riscv-mcu/e203_hbirdv2/doc/source/index.rst

.. Nuclei Board Labs documentation master file.
   You can adapt this file completely to your liking, but it should at least
   contain the root `toctree` directive.

.. toctree::
   :maxdepth: 5
   :caption: Hummingbirdv2 E203 Core and SoC
   :numbered:

Hummingbirdv2 E203 Core and SoC
===============================

.. toctree::
   :maxdepth: 3
   :numbered:

   overview/overview.rst
   core/core.rst
   soc_peripherals/ips.rst
   quick_start/index.rst
   changelog.rst
   license.rst
   appendix.rst
   glossary.rst

Indices and tables
==================

* :ref:`genindex`
* :ref:`search`
