riscv-mcu/e203_hbirdv2/doc/source/asserts/medias/sdk_fig9.jpg

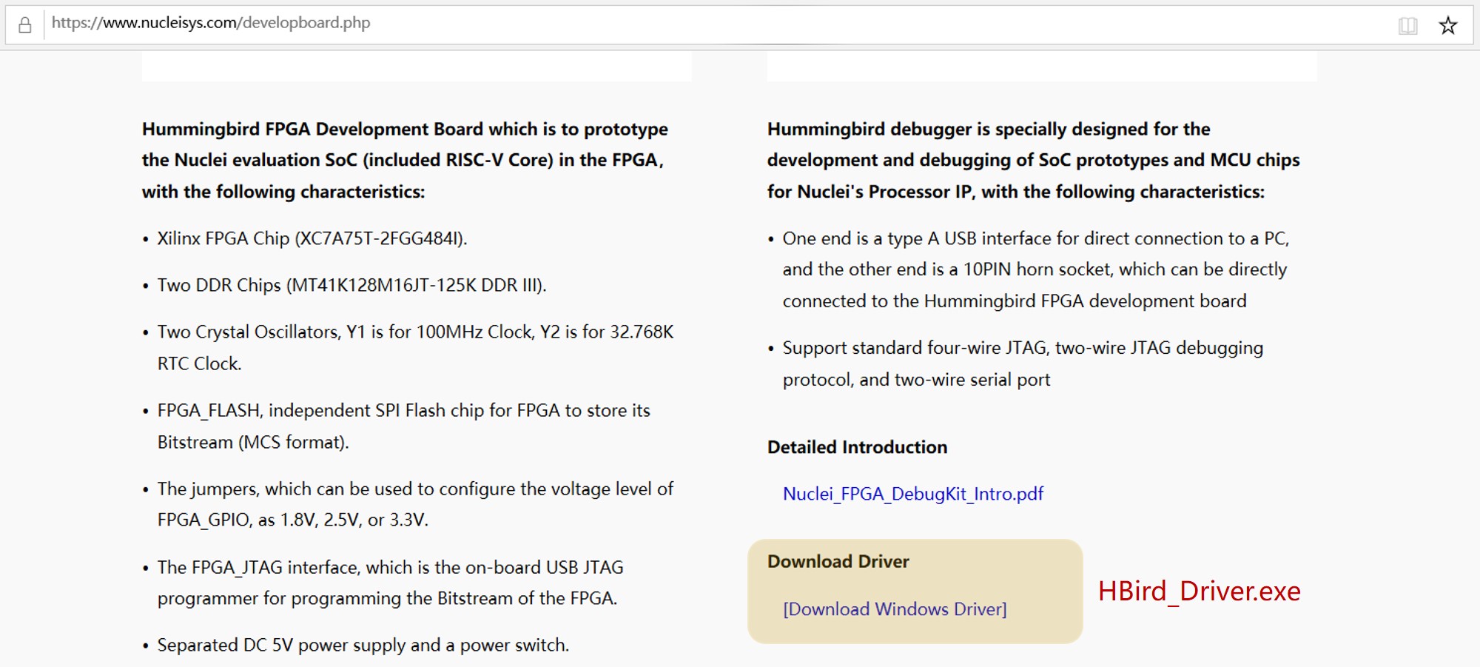
doc/source/asserts/medias/sdk_fig9.jpg
