riscv-mcu/e203_hbirdv2/(threads)

Thread 1 (2020-07-31):

Docs for NICE interface

mfkiwl, 2020-07-31:
Thank you very much for sharing the revised version of E203. It is nice to have the NICE co-processor interface included in your code.

The problem now is how to write users' own co-processors/accelerators. Any Docs on the NICE interface? It will be best if examples can be included.

Regards,
Xing

hucan7, 2020-08-03:
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

We will provide a simple user case for NICE co-processing, and the related document is ongoing... When it's ready, I will update that in README.

Thanks,
Hu Can

fanghuaqi, 2020-10-30:
See https://doc.nucleisys.com/hbirdv2

Closed 2020-08-03.

Thread 2 (2021-03-09):

question occurs when i run qsort example program on e203

zhvn100, 2021-03-09:
subprogram  can‘t  return main function through ret instr. For example, verify_qsort funct can't return main, when executing 0x80001074  pc  directly jumps to 0x00000000  ,then jumps to  interrupt funct - trap_entry(0x80000120) ，as shown in the figure below。
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。
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

According to my understanding，the  right  process  is  that verify_qsot returns to main , main returns to _init , _init returns to exit.
So , please tell me whether qsort  program can run on e203 , or where does problem maybe occur ?

hucan7, 2021-03-29:
Actually，I tried to run a test which contains qsort func on hbirdv2 SoC, and finally the result was successful.
For your case，I suggest you may check whether the "ret" is  executed correctly through checking more related signals at first.

zhvn100, 2021-03-31:
qsort func is under the benchmark dir.  whether  you  use  objcopy  to get verilog(bin) file from original  riscv(elf) file. Then through tb.v  , dump  instuction into imem.

Thread 9 (2022-08-12):

关于PLIC部分代码是否可综合问题（Is the plic code synthesizable ？ ）

clancylea, 2022-08-12:
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

please  ，Is the plic code synthesizable ？，Thanks！

hucan7, 2022-08-31:
> 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
>
> please ，Is the plic code synthesizable ？，Thanks！

Of course，you can have a try，or what's the problem you have when you did the synthesize

clancylea, 2024-11-28:
thank you，sir

Closed 2024-11-28.

Thread 10 (2022-08-31):

Nuclei Studio IDE User guide for e203_hbirdv2 is not update to date 蜂鸟二代IDE使用文档对不上

fanghuaqi, 2022-08-31:
根据文档所描述的 https://doc.nucleisys.com/hbirdv2/quick_start/ide.html 下载IDE，发现没法和最新的IDE匹配上请更新。

这里的文档能匹配的应该是 2020.09版本

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

最新的 2022.04版本无法正常使用，最新的版本使用的是NPK方式，请参照IDE文档。

蜂鸟v1/v2这里采用的hbird-sdk的NPK包，可以从https://github.com/riscv-mcu/hbird-sdk/releases/tag/0.1.3 这里下载zip包，然后通过Nuclei Package Management导入，然后使用Create Nuclei RISC-V C/C++ Project选择HummingBird对应的开发板和SoC创建对应的使用用例。

fanghuaqi, 2022-08-31:
About Nuclei NPK package, please check https://github.com/Nuclei-Software/nuclei-sdk/wiki/Nuclei-Available-NPK-Zips

fanghuaqi, 2022-08-31:
1. 下载 hbird-sdk的npk包

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

2. 如果使用蜂鸟2代，选择v2的SoC

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

3. 创建helloworld示例

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

hucan7, 2022-10-27:
Doc has been updated.
https://doc.nucleisys.com/hbirdv2/quick_start/ide_latest.html#

Closed 2022-10-27.

Thread 14 (2022-10-27):

Nuclei Studio 2022.08版本无法正常下载程序到hbird/hbirdv2 flash上

fanghuaqi, 2022-10-27:
蜂鸟SoC使用OpenOCD 0.11.0+dev-02420-g[1d0387cb](https://github.com/software/devtools/openocd/-/commit/1d0387cb14dddbf1a8021ff8b792b42f165bbdd9)版本，在ilm下载模式运行正确，在flash/flashxip下载模式会报错，可以连接上，下载时报错，截图如下。

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

fanghuaqi, 2022-10-27:
# **workaround:**

1. [芯来官网](https://www.nucleisys.com/download.php#tools)下载使用2022.04 版本的openocd, 替换掉IDE中toolchain/openocd, 注意替换前后的目录一致性

Thread 17 (2022-12-29):

关于移植到xc7z100ffg9-2出现的问题

Fahrenhell, 2022-12-29:
您好，我想请教一下，我现在把e203移植到另外一块开发板出现了以下的问题：
1、由于这块开发板的特殊性，上面的32.768KHz时钟不能供给PL端使用，所以vivado在综合的时候，这条时序路径会报错。这个问题该怎么解决？是可以忽略的吗？
2、移植过去之后，我把jtag接口和gpioA上的uart接口引了出来但是出现了以下报错：

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
为什么会没有检测到内核？

Fahrenhell, 2022-12-29:
我突然有个想法，不会是蜂鸟jtag调试器不支持xc7z100ffg9-2吧？

fanghuaqi, 2022-12-29:
可以去社区问问其他人 https://www.rvmcu.com/community-show-id-2.html

> 我突然有个想法，不会是蜂鸟jtag调试器不支持xc7z100ffg9-2吧？

蜂鸟调试器不存在不支持特定fpga的说法，一般都是自己移植没到位。

Fahrenhell, 2022-12-29:
那我再问一下，蜂鸟jtag调试器上面的uart tx和rx是连到gpioA的17和16吗？gpioA的其他引脚会影响jtag吗？因为我不想用那么多gpioA上的引脚，所以就只引了uart出来。

fanghuaqi, 2022-12-29:
> 那我再问一下，蜂鸟jtag调试器上面的uart tx和rx是连到gpioA的17和16吗？gpioA的其他引脚会影响jtag吗？因为我不想用那么多gpioA上的引脚，所以就只引了uart出来。

这个我不了解，建议仔细阅读代码和相关文档。

Fahrenhell, 2022-12-29:
那除了使用jtag，还有什么其他的办法可以知道e203跑起来了呢？

fanghuaqi, 2022-12-29:
https://doc.nucleisys.com/hbirdv2/quick_start/index.html

Fahrenhell, 2022-12-29:
这不是还是要用jtag？

Closed 2022-12-29.

Thread 19 (2023-03-10):

跑仿真遇到的一些问题

cyl-0411, 2023-03-10:
### 我根据quickstart里面的指导进行仿真，遇到了以下的一些问题：

#### 1.README存在一些小问题
`/e203_hbirdv2/vsim/README.md`中的第十四行:
原代码：`make compile SIM=iverlog **or** make compile SIM=VCS`
这里的的`iverilog`少了个`i`。

#### 2.对于Ubuntu22.04需要进行额外配置
我进行到`4.1.3. Run simulation tests`时，执行`make run_test SIM=iverilog`命令时报错，报错信息：`Syntax error: "&"unexpected`。
我根据[这个](https://www.jianshu.com/p/89b40e01d983)解决了问题。希望可以将这个问题加入文档中，让以后走到这一步的同学少走一些弯路。

fanghuaqi, 2023-03-10:
可以发个PR修复下 @cyl-0411

fanghuaqi, 2023-04-02:
Fixed by https://github.com/riscv-mcu/e203_hbirdv2/pull/21

Closed 2023-04-02.

Thread 23 (2024-01-27):

regression case rv32um-p-div fail

hbhbts, 2024-01-27:
xrun -r sp_default +DUMPWAVE=1 +TESTCASE=/home/icer/work/test/e203_hbirdv2-master/vsim/run/../../riscv-tools/riscv-tests/isa/generated/rv32um-p-div +SIM_TOOL=xrun 2>&1 | tee rv32um-p-div/rv32um-p-div.log; cd /home/icer/work/test/e203_hbirdv2-master/vsim/run;
TOOL:   xrun    20.09-s009: Started on Jan 27, 2024 at 21:16:47 CST
TOOL:   xrun(64)        20.09-s009: Started on Jan 27, 2024 at 21:16:47 CST
xrun(64): 20.09-s009: (c) Copyright 1995-2021 Cadence Design Systems, Inc.
xrun: *N,NOSNPR: The default work directory (./xcelium.d/run.lnx8664.20.09.d) is missing.  -r sp_default was used and a matching -snapshot sp_default scratch directory was found.  xrun will imply the option -snapshot sp_default.
Loading snapshot worklib.sp_default:v .................... Done
SVSEED default: 1
xmsim: *W,RNDXCELON: A newer version of the SystemVerilog constraint solver is being used which has better support for array-solving, new solve-order mechanism, and seed stability enhancements..
xcelium> source /opt/rh/XCELIUM2009/tools/xcelium/files/xmsimrc
xcelium> run
!!!!!!!!!!!!!!!!!!!!!!!!!!!!!!!!!!!!!!!!!!!!!!!!
TESTCASE=                                                                                                                                                                                                  /home/icer/work/test/e203_hbirdv2-master/vsim/run/../../riscv-tools/riscv-tests/isa/generated/rv32um-p-div
xrun used
xmsim: *W,PRUASZ: Unpacked array at "tb_top.itcm_mem" of 65536 elements exceeds limit of 16384 - not probed
 Use 'probe -create -unpacked 65536 tb_top.itcm_mem' or 'setenv SHM_UNPACKED_LIMIT 65536' to adjust limit.
ITCM 0x00: 340510730001aa0d
ITCM 0x01: ff85051300002517
ITCM 0x02: 01f5222301e52023
ITCM 0x03: 040f416334202f73
ITCM 0x04: 4fa507ff02634fa1
ITCM 0x05: 0c634fad05ff0f63
ITCM 0x06: 0bff05634f8505ff
ITCM 0x07: 4f9d0dff00634f95
ITCM 0x16: 2f03f52505130000
ITCM 0x20: 2f8300052f03f065
??????????????????????????????????????????
??????????????????????????????????????????
{i_mul,i_mulh,i_mulhsu,i_mulhu,i_div,i_divu,i_rem,i_remu}=00001000
muldiv_i_rs1=ffffffec
muldiv_i_rs2=00000006

golden_res=55555552
muldiv_o_wbck_wdat=fffffffd
??????????????????????????????????????????
xmsim: *F,ASRTST (../install/rtl/core/e203_exu_alu_muldiv.v,624): (time 93648 NS) Assertion tb_top.u_e203_soc_top.u_e203_subsys_top.u_e203_subsys_main.u_e203_cpu_top.u_e203_cpu.u_e203_core.u_e203_exu.u_e203_exu_alu.u_e203_exu_alu_muldiv.CHECK_GOLD_AND_ACTUAL_SAME has failed
Memory Usage - Current physical: 97.6M, Current virtual: 458.4M
CPU Usage - 0.6s system + 3.8s user = 4.3s total (100.0% cpu)
Simulation terminated via $fatal(2) at time 93648 NS + 6
../install/rtl/core/e203_exu_alu_muldiv.v:624         $fatal ("\n Error: Oops, This should never happen. \n");
xcelium> exit
TOOL:   xrun(64)        20.09-s009: Exiting on Jan 27, 2024 at 21:16:50 CST  (total: 00:00:03)
make[1]: Leaving directory `/home/icer/work/test/e203_hbirdv2-master/vsim/run'

Thread 24 (2024-03-07):

求NICE接口搭载协处理器教程或者资源

ichxm, 2024-03-07:
我正在学习如何在NICE接口搭载协处理器，比如乘法器+加法器+……，然后用自定义指令1、2……去调用他们，请问大家有没有相关教程，或者相关资源，万分感谢！@、

fanghuaqi, 2024-03-08:
https://doc.nucleisys.com/hbirdv2/core/core.html#nice @ichxm

fanghuaqi, 2024-03-08:
https://www.rvmcu.com/community-show-id-2.html 也可以在这里搜下历史的文章和问题

Closed 2024-03-08.

Thread 28 (2024-11-28):

【rtl bug】e203_subsys_nice_core 模块仿真，lbuf指令nice_req发出后没有返回nice_rsp

clancylea, 2024-11-28:
Hi，hbirdv2 team
帮忙确认下是否存在如下问题：
最后一个icb访存的rsp valid拉高后，lbuf_cnt_last才拉高，导致没有返回nice响应；

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

建议修改如下：
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

clancylea, 2024-11-28:
不好意思，写了错误rs1的地址，这里rtl没有问题

clancylea, 2024-11-28:
不好意思，写了错误rs1的地址，这里rtl没有问题

clancylea, 2024-11-28:
不好意思，写了错误rs1的地址，这里rtl没有问题

Closed 2024-11-28.
