riscv-mcu/e203_hbirdv2/tb/tb_top.v

`include "e203_defines.v"

module tb_top();

  reg  clk;
  reg  lfextclk;
  reg  rst_n;

  wire hfclk = clk;

  `define CPU_TOP u_e203_soc_top.u_e203_subsys_top.u_e203_subsys_main.u_e203_cpu_top
  `define EXU `CPU_TOP.u_e203_cpu.u_e203_core.u_e203_exu
  `define ITCM `CPU_TOP.u_e203_srams.u_e203_itcm_ram.u_e203_itcm_gnrl_ram.u_sirv_sim_ram

  `define PC_WRITE_TOHOST       `E203_PC_SIZE'h80000086
  `define PC_EXT_IRQ_BEFOR_MRET `E203_PC_SIZE'h800000a6
  `define PC_SFT_IRQ_BEFOR_MRET `E203_PC_SIZE'h800000be
  `define PC_TMR_IRQ_BEFOR_MRET `E203_PC_SIZE'h800000d6
  `define PC_AFTER_SETMTVEC     `E203_PC_SIZE'h8000015C

  wire [`E203_XLEN-1:0] x3 = `EXU.u_e203_exu_regfile.rf_r[3];
  wire [`E203_PC_SIZE-1:0] pc = `EXU.u_e203_exu_commit.alu_cmt_i_pc;
  wire [`E203_PC_SIZE-1:0] pc_vld = `EXU.u_e203_exu_commit.alu_cmt_i_valid;

  reg [31:0] pc_write_to_host_cnt;
  reg [31:0] pc_write_to_host_cycle;
  reg [31:0] valid_ir_cycle;
  reg [31:0] cycle_count;
  reg pc_write_to_host_flag;

  always @(posedge hfclk or negedge rst_n)
  begin 
    if(rst_n == 1'b0) begin
        pc_write_to_host_cnt <= 32'b0;
        pc_write_to_host_flag <= 1'b0;
        pc_write_to_host_cycle <= 32'b0;
    end
    else if (pc_vld & (pc == `PC_WRITE_TOHOST)) begin
        pc_write_to_host_cnt <= pc_write_to_host_cnt + 1'b1;
        pc_write_to_host_flag <= 1'b1;
        if (pc_write_to_host_flag == 1'b0) begin
            pc_write_to_host_cycle <= cycle_count;
        end
    end
  end

  always @(posedge hfclk or negedge rst_n)
  begin 
    if(rst_n == 1'b0) begin
        cycle_count <= 32'b0;
    end
    else begin
        cycle_count <= cycle_count + 1'b1;
    end
  end

  wire i_valid = `EXU.i_valid;
  wire i_ready = `EXU.i_ready;

  always @(posedge hfclk or negedge rst_n)
  begin 
    if(rst_n == 1'b0) begin
        valid_ir_cycle <= 32'b0;
    end
    else if(i_valid & i_ready & (pc_write_to_host_flag == 1'b0)) begin
        valid_ir_cycle <= valid_ir_cycle + 1'b1;
    end
  end


  // Randomly force the external interrupt
  `define EXT_IRQ u_e203_soc_top.u_e203_subsys_top.u_e203_subsys_main.plic_ext_irq
  `define SFT_IRQ u_e203_soc_top.u_e203_subsys_top.u_e203_subsys_main.clint_sft_irq
  `define TMR_IRQ u_e203_soc_top.u_e203_subsys_top.u_e203_subsys_main.clint_tmr_irq

  `define U_CPU u_e203_soc_top.u_e203_subsys_top.u_e203_subsys_main.u_e203_cpu_top.u_e203_cpu
  `define ITCM_BUS_ERR `U_CPU.u_e203_itcm_ctrl.sram_icb_rsp_err
  `define ITCM_BUS_READ `U_CPU.u_e203_itcm_ctrl.sram_icb_rsp_read
  `define STATUS_MIE   `U_CPU.u_e203_core.u_e203_exu.u_e203_exu_commit.u_e203_exu_excp.status_mie_r

  wire stop_assert_irq = (pc_write_to_host_cnt > 32);

  reg tb_itcm_bus_err;

  reg tb_ext_irq;
  reg tb_tmr_irq;
  reg tb_sft_irq;
  initial begin
    tb_ext_irq = 1'b0;
    tb_tmr_irq = 1'b0;
    tb_sft_irq = 1'b0;
  end

`ifdef ENABLE_TB_FORCE
  initial begin
    tb_itcm_bus_err = 1'b0;
    #100
    @(pc == `PC_AFTER_SETMTVEC ) // Wait the program goes out the reset_vector program
    forever begin
      repeat ($urandom_range(1, 20)) @(posedge clk) tb_itcm_bus_err = 1'b0; // Wait random times
      repeat ($urandom_range(1, 200)) @(posedge clk) tb_itcm_bus_err = 1'b1; // Wait random times
      if(stop_assert_irq) begin
          break;
      end
    end
  end


  initial begin
    force `EXT_IRQ = tb_ext_irq;
    force `SFT_IRQ = tb_sft_irq;
    force `TMR_IRQ = tb_tmr_irq;
       // We force the bus-error only when:
       //   It is in common code, not in exception code, by checking MIE bit
       //   It is in read operation, not write, otherwise the test cannot recover
    force `ITCM_BUS_ERR = tb_itcm_bus_err
                        & `STATUS_MIE 
                        & `ITCM_BUS_READ
                        ;
  end


  initial begin
    #100
    @(pc == `PC_AFTER_SETMTVEC ) // Wait the program goes out the reset_vector program
    forever begin
      repeat ($urandom_range(1, 1000)) @(posedge clk) tb_ext_irq = 1'b0; // Wait random times
      tb_ext_irq = 1'b1; // assert the irq
      @((pc == `PC_EXT_IRQ_BEFOR_MRET)) // Wait the program run into the IRQ handler by check PC values
      tb_ext_irq = 1'b0;
      if(stop_assert_irq) begin
          break;
      end
    end
  end

  initial begin
    #100
    @(pc == `PC_AFTER_SETMTVEC ) // Wait the program goes out the reset_vector program
    forever begin
      repeat ($urandom_range(1, 1000)) @(posedge clk) tb_sft_irq = 1'b0; // Wait random times
      tb_sft_irq = 1'b1; // assert the irq
      @((pc == `PC_SFT_IRQ_BEFOR_MRET)) // Wait the program run into the IRQ handler by check PC values
      tb_sft_irq = 1'b0;
      if(stop_assert_irq) begin
          break;
      end
    end
  end

  initial begin
    #100
    @(pc == `PC_AFTER_SETMTVEC ) // Wait the program goes out the reset_vector program
    forever begin
      repeat ($urandom_range(1, 1000)) @(posedge clk) tb_tmr_irq = 1'b0; // Wait random times
      tb_tmr_irq = 1'b1; // assert the irq
      @((pc == `PC_TMR_IRQ_BEFOR_MRET)) // Wait the program run into the IRQ handler by check PC values
      tb_tmr_irq = 1'b0;
      if(stop_assert_irq) begin
          break;
      end
    end
  end
`endif

  reg[8*300:1] testcase;
  integer dumpwave;

  initial begin
    $display("!!!!!!!!!!!!!!!!!!!!!!!!!!!!!!!!!!!!!!!!!!!!!!!!");  
    if($value$plusargs("TESTCASE=%s",testcase))begin
      $display("TESTCASE=%s",testcase);
    end

    pc_write_to_host_flag <=0;
    clk   <=0;
    lfextclk   <=0;
    rst_n <=0;
    #120 rst_n <=1;

    @(pc_write_to_host_cnt == 32'd8) #10 rst_n <=1;
`ifdef ENABLE_TB_FORCE
    @((~tb_tmr_irq) & (~tb_sft_irq) & (~tb_ext_irq)) #10 rst_n <=1;// Wait the interrupt to complete
`endif

        $display("~~~~~~~~~~~~~~~~~~~~~~~~~~~~~~~~~~~~~~~~~~~~~~~~~~~~~~~~");
        $display("~~~~~~~~~~~~~~~~~~~~~~~~~~~~~~~~~~~~~~~~~~~~~~~~~~~~~~~~");
        $display("~~~~~~~~~~~~~ Test Result Summary ~~~~~~~~~~~~~~~~~~~~~~");
        $display("~~~~~~~~~~~~~~~~~~~~~~~~~~~~~~~~~~~~~~~~~~~~~~~~~~~~~~~~");
        $display("~~~~~~~~~~~~~~~~~~~~~~~~~~~~~~~~~~~~~~~~~~~~~~~~~~~~~~~~");
        $display("~TESTCASE: %s ~~~~~~~~~~~~~", testcase);
        $display("~~~~~~~~~~~~~~Total cycle_count value: %d ~~~~~~~~~~~~~", cycle_count);
        $display("~~~~~~~~~~The valid Instruction Count: %d ~~~~~~~~~~~~~", valid_ir_cycle);
        $display("~~~~~The test ending reached at cycle: %d ~~~~~~~~~~~~~", pc_write_to_host_cycle);
        $display("~~~~~~~~~~~~~~~The final x3 Reg value: %d ~~~~~~~~~~~~~", x3);
        $display("~~~~~~~~~~~~~~~~~~~~~~~~~~~~~~~~~~~~~~~~~~~~~~~~~~~~~~~~");
    if (x3 == 1) begin
        $display("~~~~~~~~~~~~~~~~ TEST_PASS ~~~~~~~~~~~~~~~~~~~~~~~~~~~~~");
        $display("~~~~~~~~~~~~~~~~~~~~~~~~~~~~~~~~~~~~~~~~~~~~~~~~~~~~~~~~");
        $display("~~~~~~~~~ #####     ##     ####    #### ~~~~~~~~~~~~~~~~");
        $display("~~~~~~~~~ #    #   #  #   #       #     ~~~~~~~~~~~~~~~~");
        $display("~~~~~~~~~ #    #  #    #   ####    #### ~~~~~~~~~~~~~~~~");
        $display("~~~~~~~~~ #####   ######       #       #~~~~~~~~~~~~~~~~");
        $display("~~~~~~~~~ #       #    #  #    #  #    #~~~~~~~~~~~~~~~~");
        $display("~~~~~~~~~ #       #    #   ####    #### ~~~~~~~~~~~~~~~~");
        $display("~~~~~~~~~~~~~~~~~~~~~~~~~~~~~~~~~~~~~~~~~~~~~~~~~~~~~~~~");
    end
    else begin
        $display("~~~~~~~~~~~~~~~~ TEST_FAIL ~~~~~~~~~~~~~~~~~~~~~~~~~~~~~");
        $display("~~~~~~~~~~~~~~~~~~~~~~~~~~~~~~~~~~~~~~~~~~~~~~~~~~~~~~~~");
        $display("~~~~~~~~~~######    ##       #    #     ~~~~~~~~~~~~~~~~");
        $display("~~~~~~~~~~#        #  #      #    #     ~~~~~~~~~~~~~~~~");
        $display("~~~~~~~~~~#####   #    #     #    #     ~~~~~~~~~~~~~~~~");
        $display("~~~~~~~~~~#       ######     #    #     ~~~~~~~~~~~~~~~~");
        $display("~~~~~~~~~~#       #    #     #    #     ~~~~~~~~~~~~~~~~");
        $display("~~~~~~~~~~#       #    #     #    ######~~~~~~~~~~~~~~~~");
        $display("~~~~~~~~~~~~~~~~~~~~~~~~~~~~~~~~~~~~~~~~~~~~~~~~~~~~~~~~");
    end
    #10
     $finish;
  end

  initial begin
    #40000000
        $display("Time Out !!!");
     $finish;
  end

  always
  begin 
     #2 clk <= ~clk;
  end

  always
  begin 
     #33 lfextclk <= ~lfextclk;
  end



  
  
  initial begin
    if($value$plusargs("DUMPWAVE=%d",dumpwave)) begin
      if(dumpwave != 0) begin

	 `ifdef vcs
            $display("VCS used");
            $fsdbDumpfile("tb_top.fsdb");
            $fsdbDumpvars(0, tb_top, "+mda");
         `endif

	 `ifdef iverilog
            $display("iverlog used");
	    $dumpfile("tb_top.vcd");
            $dumpvars(0, tb_top);
         `endif
      end
    end
  end




  integer i;

    reg [7:0] itcm_mem [0:(`E203_ITCM_RAM_DP*8)-1];
    initial begin
      $readmemh({testcase, ".verilog"}, itcm_mem);

      for (i=0;i<(`E203_ITCM_RAM_DP);i=i+1) begin
          `ITCM.mem_r[i][00+7:00] = itcm_mem[i*8+0];
          `ITCM.mem_r[i][08+7:08] = itcm_mem[i*8+1];
          `ITCM.mem_r[i][16+7:16] = itcm_mem[i*8+2];
          `ITCM.mem_r[i][24+7:24] = itcm_mem[i*8+3];
          `ITCM.mem_r[i][32+7:32] = itcm_mem[i*8+4];
          `ITCM.mem_r[i][40+7:40] = itcm_mem[i*8+5];
          `ITCM.mem_r[i][48+7:48] = itcm_mem[i*8+6];
          `ITCM.mem_r[i][56+7:56] = itcm_mem[i*8+7];
      end

        $display("ITCM 0x00: %h", `ITCM.mem_r[8'h00]);
        $display("ITCM 0x01: %h", `ITCM.mem_r[8'h01]);
        $display("ITCM 0x02: %h", `ITCM.mem_r[8'h02]);
        $display("ITCM 0x03: %h", `ITCM.mem_r[8'h03]);
        $display("ITCM 0x04: %h", `ITCM.mem_r[8'h04]);
        $display("ITCM 0x05: %h", `ITCM.mem_r[8'h05]);
        $display("ITCM 0x06: %h", `ITCM.mem_r[8'h06]);
        $display("ITCM 0x07: %h", `ITCM.mem_r[8'h07]);
        $display("ITCM 0x16: %h", `ITCM.mem_r[8'h16]);
        $display("ITCM 0x20: %h", `ITCM.mem_r[8'h20]);

    end 



  wire jtag_TDI = 1'b0;
  wire jtag_TDO;
  wire jtag_TCK = 1'b0;
  wire jtag_TMS = 1'b0;
  wire jtag_TRST = 1'b0;

  wire jtag_DRV_TDO = 1'b0;


e203_soc_top u_e203_soc_top(
   
   .hfextclk(hfclk),
   .hfxoscen(),

   .lfextclk(lfextclk),
   .lfxoscen(),

   .io_pads_jtag_TCK_i_ival (jtag_TCK),
   .io_pads_jtag_TMS_i_ival (jtag_TMS),
   .io_pads_jtag_TDI_i_ival (jtag_TDI),
   .io_pads_jtag_TDO_o_oval (jtag_TDO),
   .io_pads_jtag_TDO_o_oe (),

   .io_pads_gpioA_i_ival(32'b0),
   .io_pads_gpioA_o_oval(),
   .io_pads_gpioA_o_oe  (),

   .io_pads_gpioB_i_ival(32'b0),
   .io_pads_gpioB_o_oval(),
   .io_pads_gpioB_o_oe  (),

   .io_pads_qspi0_sck_o_oval (),
   .io_pads_qspi0_cs_0_o_oval(),
   .io_pads_qspi0_dq_0_i_ival(1'b1),
   .io_pads_qspi0_dq_0_o_oval(),
   .io_pads_qspi0_dq_0_o_oe  (),
   .io_pads_qspi0_dq_1_i_ival(1'b1),
   .io_pads_qspi0_dq_1_o_oval(),
   .io_pads_qspi0_dq_1_o_oe  (),
   .io_pads_qspi0_dq_2_i_ival(1'b1),
   .io_pads_qspi0_dq_2_o_oval(),
   .io_pads_qspi0_dq_2_o_oe  (),
   .io_pads_qspi0_dq_3_i_ival(1'b1),
   .io_pads_qspi0_dq_3_o_oval(),
   .io_pads_qspi0_dq_3_o_oe  (),

   .io_pads_aon_erst_n_i_ival (rst_n),//This is the real reset, active low
   .io_pads_aon_pmu_dwakeup_n_i_ival (1'b1),

   .io_pads_aon_pmu_vddpaden_o_oval (),
    .io_pads_aon_pmu_padrst_o_oval    (),

    .io_pads_bootrom_n_i_ival       (1'b0),// In Simulation we boot from ROM
    .io_pads_dbgmode0_n_i_ival       (1'b1),
    .io_pads_dbgmode1_n_i_ival       (1'b1),
    .io_pads_dbgmode2_n_i_ival       (1'b1) 
);


endmodule
