riscv-mcu/e203_hbirdv2/rtl/e203/perips/sirv_flash_qspi_top.v

 /*                                                                      
 Copyright 2018-2020 Nuclei System Technology, Inc.                
                                                                         
 Licensed under the Apache License, Version 2.0 (the "License");         
 you may not use this file except in compliance with the License.        
 You may obtain a copy of the License at                                 
                                                                         
     http://www.apache.org/licenses/LICENSE-2.0                          
                                                                         
  Unless required by applicable law or agreed to in writing, software    
 distributed under the License is distributed on an "AS IS" BASIS,       
 WITHOUT WARRANTIES OR CONDITIONS OF ANY KIND, either express or implied.
 See the License for the specific language governing permissions and     
 limitations under the License.                                          
 */                                                                      
                                                                         
                                                                         
                                                                         
//=====================================================================
//
// Designer   : Bob Hu
//
// Description:
//  The top level module of flash-qspi
//
// ====================================================================

module sirv_flash_qspi_top(
  input   clk,
  input   rst_n,

  input                      i_icb_cmd_valid,
  output                     i_icb_cmd_ready,
  input  [32-1:0]            i_icb_cmd_addr, 
  input                      i_icb_cmd_read, 
  input  [32-1:0]            i_icb_cmd_wdata,
  
  output                     i_icb_rsp_valid,
  input                      i_icb_rsp_ready,
  output [32-1:0]            i_icb_rsp_rdata,

  input                      f_icb_cmd_valid,
  output                     f_icb_cmd_ready,
  input  [32-1:0]            f_icb_cmd_addr, 
  input                      f_icb_cmd_read, 
  input  [32-1:0]            f_icb_cmd_wdata,
  
  output                     f_icb_rsp_valid,
  input                      f_icb_rsp_ready,
  output [32-1:0]            f_icb_rsp_rdata,

  output  io_port_sck,
  input   io_port_dq_0_i,
  output  io_port_dq_0_o,
  output  io_port_dq_0_oe,
  input   io_port_dq_1_i,
  output  io_port_dq_1_o,
  output  io_port_dq_1_oe,
  input   io_port_dq_2_i,
  output  io_port_dq_2_o,
  output  io_port_dq_2_oe,
  input   io_port_dq_3_i,
  output  io_port_dq_3_o,
  output  io_port_dq_3_oe,
  output  io_port_cs_0,
  output  io_tl_i_0_0 
);


  wire  io_tl_r_0_a_ready;
  assign  i_icb_cmd_ready  = io_tl_r_0_a_ready;
  wire  io_tl_r_0_a_valid  = i_icb_cmd_valid;
  wire  [2:0] io_tl_r_0_a_bits_opcode  = i_icb_cmd_read ? 3'h4 : 3'h0;
  wire  [2:0] io_tl_r_0_a_bits_param  = 3'b0;
  wire  [2:0] io_tl_r_0_a_bits_size = 3'd2;
  wire  [4:0] io_tl_r_0_a_bits_source  = 5'b0;
  wire  [28:0] io_tl_r_0_a_bits_address  = i_icb_cmd_addr[28:0];
  wire  [3:0] io_tl_r_0_a_bits_mask  = 4'b1111;
  wire  [31:0] io_tl_r_0_a_bits_data  = i_icb_cmd_wdata;

  
  wire  io_tl_r_0_d_ready = i_icb_rsp_ready;

  wire  [2:0] io_tl_r_0_d_bits_opcode;
  wire  [1:0] io_tl_r_0_d_bits_param;
  wire  [2:0] io_tl_r_0_d_bits_size;
  wire  [4:0] io_tl_r_0_d_bits_source;
  wire  io_tl_r_0_d_bits_sink;
  wire  [1:0] io_tl_r_0_d_bits_addr_lo;
  wire  [31:0] io_tl_r_0_d_bits_data;
  wire  io_tl_r_0_d_bits_error;
  wire  io_tl_r_0_d_valid;

  assign  i_icb_rsp_valid = io_tl_r_0_d_valid;
  assign  i_icb_rsp_rdata = io_tl_r_0_d_bits_data;

  // Not used
  wire  io_tl_r_0_b_ready = 1'b0;
  wire  io_tl_r_0_b_valid;
  wire  [2:0] io_tl_r_0_b_bits_opcode;
  wire  [1:0] io_tl_r_0_b_bits_param;
  wire  [2:0] io_tl_r_0_b_bits_size;
  wire  [4:0] io_tl_r_0_b_bits_source;
  wire  [28:0] io_tl_r_0_b_bits_address;
  wire  [3:0] io_tl_r_0_b_bits_mask;
  wire  [31:0] io_tl_r_0_b_bits_data;

  // Not used
  wire  io_tl_r_0_c_ready;
  wire  io_tl_r_0_c_valid = 1'b0;
  wire  [2:0] io_tl_r_0_c_bits_opcode = 3'b0;
  wire  [2:0] io_tl_r_0_c_bits_param = 3'b0;
  wire  [2:0] io_tl_r_0_c_bits_size = 3'd2;
  wire  [4:0] io_tl_r_0_c_bits_source = 5'b0;
  wire  [28:0] io_tl_r_0_c_bits_address = 29'b0;
  wire  [31:0] io_tl_r_0_c_bits_data = 32'b0;
  wire  io_tl_r_0_c_bits_error = 1'b0;

  // Not used
  wire  io_tl_r_0_e_ready;
  wire  io_tl_r_0_e_valid = 1'b0;
  wire  io_tl_r_0_e_bits_sink = 1'b0;

  /////////////////////////////////////////////////////////////////////////////
  /////////////////////////////////////////////////////////////////////////////

  wire  io_tl_f_0_a_ready;
  assign  f_icb_cmd_ready  = io_tl_f_0_a_ready;
  wire  io_tl_f_0_a_valid  = f_icb_cmd_valid;
  wire  [2:0] io_tl_f_0_a_bits_opcode  = f_icb_cmd_read ? 3'h4 : 3'h0;
  wire  [2:0] io_tl_f_0_a_bits_param  = 3'b0;
  wire  [2:0] io_tl_f_0_a_bits_size = 3'd2;
  wire  [1:0] io_tl_f_0_a_bits_source  = 2'b0;
  // We must force the address to be aligned to 32bits
  wire  [29:0] io_tl_f_0_a_bits_address  = {f_icb_cmd_addr[29:2],2'b0};
  wire  [3:0] io_tl_f_0_a_bits_mask  = 4'b1111;
  wire  [31:0] io_tl_f_0_a_bits_data  = f_icb_cmd_wdata;

  
  wire  io_tl_f_0_d_ready = f_icb_rsp_ready;

  wire  [2:0] io_tl_f_0_d_bits_opcode;
  wire  [1:0] io_tl_f_0_d_bits_param;
  wire  [2:0] io_tl_f_0_d_bits_size;
  wire  [1:0] io_tl_f_0_d_bits_source;
  wire  io_tl_f_0_d_bits_sink;
  wire  [1:0] io_tl_f_0_d_bits_addr_lo;
  wire  [31:0] io_tl_f_0_d_bits_data;
  wire  io_tl_f_0_d_bits_error;
  wire  io_tl_f_0_d_valid;

  assign  f_icb_rsp_valid = io_tl_f_0_d_valid;
  assign  f_icb_rsp_rdata = io_tl_f_0_d_bits_data;

  // Not used
  wire  io_tl_f_0_b_ready = 1'b0;
  wire  io_tl_f_0_b_valid;
  wire  [2:0] io_tl_f_0_b_bits_opcode;
  wire  [1:0] io_tl_f_0_b_bits_param;
  wire  [2:0] io_tl_f_0_b_bits_size;
  wire  [1:0] io_tl_f_0_b_bits_source;
  wire  [29:0] io_tl_f_0_b_bits_address;
  wire  [3:0] io_tl_f_0_b_bits_mask;
  wire  [31:0] io_tl_f_0_b_bits_data;

  // Not used
  wire  io_tl_f_0_c_ready;
  wire  io_tl_f_0_c_valid = 1'b0;
  wire  [2:0] io_tl_f_0_c_bits_opcode = 3'b0;
  wire  [2:0] io_tl_f_0_c_bits_param = 3'b0;
  wire  [2:0] io_tl_f_0_c_bits_size = 3'd2;
  wire  [1:0] io_tl_f_0_c_bits_source = 2'b0;
  wire  [29:0] io_tl_f_0_c_bits_address = 30'b0;
  wire  [31:0] io_tl_f_0_c_bits_data = 32'b0;
  wire  io_tl_f_0_c_bits_error = 1'b0;

  // Not used
  wire  io_tl_f_0_e_ready;
  wire  io_tl_f_0_e_valid = 1'b0;
  wire  io_tl_f_0_e_bits_sink = 1'b0;

  /////////////////////////////////////////////////////////////////////////////
  /////////////////////////////////////////////////////////////////////////////

  wire  tl_f_0_a_ready;
  wire  tl_f_0_a_valid;
  wire  [2:0] tl_f_0_a_bits_opcode;
  wire  [2:0] tl_f_0_a_bits_param;
  wire  [2:0] tl_f_0_a_bits_size;
  wire  [6:0] tl_f_0_a_bits_source;
  wire  [29:0] tl_f_0_a_bits_address;
  wire  tl_f_0_a_bits_mask;
  wire  [7:0] tl_f_0_a_bits_data;

  
  wire  io_in_0_a_ready;
  wire  io_in_0_a_valid;
  wire [2:0] io_in_0_a_bits_opcode;
  wire [2:0] io_in_0_a_bits_param;
  wire [2:0] io_in_0_a_bits_size;
  wire [1:0] io_in_0_a_bits_source;
  wire [29:0] io_in_0_a_bits_address;
  wire  io_in_0_a_bits_mask;
  wire [7:0] io_in_0_a_bits_data;
  wire  io_in_0_b_ready;
  wire  io_in_0_b_valid;
  wire [2:0] io_in_0_b_bits_opcode;
  wire [1:0] io_in_0_b_bits_param;
  wire [2:0] io_in_0_b_bits_size;
  wire [1:0] io_in_0_b_bits_source;
  wire [29:0] io_in_0_b_bits_address;
  wire  io_in_0_b_bits_mask;
  wire [7:0] io_in_0_b_bits_data;
  wire  io_in_0_c_ready;
  wire  io_in_0_c_valid;
  wire [2:0] io_in_0_c_bits_opcode;
  wire [2:0] io_in_0_c_bits_param;
  wire [2:0] io_in_0_c_bits_size;
  wire [1:0] io_in_0_c_bits_source;
  wire [29:0] io_in_0_c_bits_address;
  wire [7:0] io_in_0_c_bits_data;
  wire  io_in_0_c_bits_error;
  wire  io_in_0_d_ready;
  wire  io_in_0_d_valid;
  wire [2:0] io_in_0_d_bits_opcode;
  wire [1:0] io_in_0_d_bits_param;
  wire [2:0] io_in_0_d_bits_size;
  wire [1:0] io_in_0_d_bits_source;
  wire  io_in_0_d_bits_sink;
  wire  io_in_0_d_bits_addr_lo;
  wire [7:0] io_in_0_d_bits_data;
  wire  io_in_0_d_bits_error;
  wire  io_in_0_e_ready;
  wire  io_in_0_e_valid;
  wire  io_in_0_e_bits_sink;

  wire  io_out_0_a_ready;
  wire  io_out_0_a_valid;
  wire [2:0] io_out_0_a_bits_opcode;
  wire [2:0] io_out_0_a_bits_param;
  wire [2:0] io_out_0_a_bits_size;
  wire [6:0] io_out_0_a_bits_source;
  wire [29:0] io_out_0_a_bits_address;
  wire  io_out_0_a_bits_mask;
  wire [7:0] io_out_0_a_bits_data;
  wire  io_out_0_b_ready;
  wire  io_out_0_b_valid;
  wire [2:0] io_out_0_b_bits_opcode;
  wire [1:0] io_out_0_b_bits_param;
  wire [2:0] io_out_0_b_bits_size;
  wire [6:0] io_out_0_b_bits_source;
  wire [29:0] io_out_0_b_bits_address;
  wire  io_out_0_b_bits_mask;
  wire [7:0] io_out_0_b_bits_data;
  wire  io_out_0_c_ready;
  wire  io_out_0_c_valid;
  wire [2:0] io_out_0_c_bits_opcode;
  wire [2:0] io_out_0_c_bits_param;
  wire [2:0] io_out_0_c_bits_size;
  wire [6:0] io_out_0_c_bits_source;
  wire [29:0] io_out_0_c_bits_address;
  wire [7:0] io_out_0_c_bits_data;
  wire  io_out_0_c_bits_error;
  wire  io_out_0_d_ready;
  wire  io_out_0_d_valid;
  wire [2:0] io_out_0_d_bits_opcode;
  wire [1:0] io_out_0_d_bits_param;
  wire [2:0] io_out_0_d_bits_size;
  wire [6:0] io_out_0_d_bits_source;
  wire  io_out_0_d_bits_sink;
  wire  io_out_0_d_bits_addr_lo;
  wire [7:0] io_out_0_d_bits_data;
  wire  io_out_0_d_bits_error;
  wire  io_out_0_e_ready;
  wire  io_out_0_e_valid;
  wire  io_out_0_e_bits_sink;


  sirv_tlwidthwidget_qspi qspi_TLWidthWidget (
    .clock(clk),
    .reset(~rst_n),
    .io_in_0_a_ready(io_tl_f_0_a_ready),
    .io_in_0_a_valid(io_tl_f_0_a_valid),
    .io_in_0_a_bits_opcode(io_tl_f_0_a_bits_opcode),
    .io_in_0_a_bits_param(io_tl_f_0_a_bits_param),
    .io_in_0_a_bits_size(io_tl_f_0_a_bits_size),
    .io_in_0_a_bits_source(io_tl_f_0_a_bits_source),
    .io_in_0_a_bits_address(io_tl_f_0_a_bits_address),
    .io_in_0_a_bits_mask(io_tl_f_0_a_bits_mask),
    .io_in_0_a_bits_data(io_tl_f_0_a_bits_data),
    .io_in_0_b_ready(io_tl_f_0_b_ready),
    .io_in_0_b_valid(io_tl_f_0_b_valid),
    .io_in_0_b_bits_opcode(io_tl_f_0_b_bits_opcode),
    .io_in_0_b_bits_param(io_tl_f_0_b_bits_param),
    .io_in_0_b_bits_size(io_tl_f_0_b_bits_size),
    .io_in_0_b_bits_source(io_tl_f_0_b_bits_source),
    .io_in_0_b_bits_address(io_tl_f_0_b_bits_address),
    .io_in_0_b_bits_mask(io_tl_f_0_b_bits_mask),
    .io_in_0_b_bits_data(io_tl_f_0_b_bits_data),
    .io_in_0_c_ready(io_tl_f_0_c_ready),
    .io_in_0_c_valid(io_tl_f_0_c_valid),
    .io_in_0_c_bits_opcode(io_tl_f_0_c_bits_opcode),
    .io_in_0_c_bits_param(io_tl_f_0_c_bits_param),
    .io_in_0_c_bits_size(io_tl_f_0_c_bits_size),
    .io_in_0_c_bits_source(io_tl_f_0_c_bits_source),
    .io_in_0_c_bits_address(io_tl_f_0_c_bits_address),
    .io_in_0_c_bits_data(io_tl_f_0_c_bits_data),
    .io_in_0_c_bits_error(io_tl_f_0_c_bits_error),
    .io_in_0_d_ready(io_tl_f_0_d_ready),
    .io_in_0_d_valid(io_tl_f_0_d_valid),
    .io_in_0_d_bits_opcode(io_tl_f_0_d_bits_opcode),
    .io_in_0_d_bits_param(io_tl_f_0_d_bits_param),
    .io_in_0_d_bits_size(io_tl_f_0_d_bits_size),
    .io_in_0_d_bits_source(io_tl_f_0_d_bits_source),
    .io_in_0_d_bits_sink(io_tl_f_0_d_bits_sink),
    .io_in_0_d_bits_addr_lo(io_tl_f_0_d_bits_addr_lo),
    .io_in_0_d_bits_data(io_tl_f_0_d_bits_data),
    .io_in_0_d_bits_error(io_tl_f_0_d_bits_error),
    .io_in_0_e_ready(io_tl_f_0_e_ready),
    .io_in_0_e_valid(io_tl_f_0_e_valid),
    .io_in_0_e_bits_sink(io_tl_f_0_e_bits_sink),

    .io_out_0_a_ready(io_in_0_a_ready),
    .io_out_0_a_valid(io_in_0_a_valid),
    .io_out_0_a_bits_opcode(io_in_0_a_bits_opcode),
    .io_out_0_a_bits_param(io_in_0_a_bits_param),
    .io_out_0_a_bits_size(io_in_0_a_bits_size),
    .io_out_0_a_bits_source(io_in_0_a_bits_source),
    .io_out_0_a_bits_address(io_in_0_a_bits_address),
    .io_out_0_a_bits_mask(io_in_0_a_bits_mask),
    .io_out_0_a_bits_data(io_in_0_a_bits_data),
    .io_out_0_b_ready(io_in_0_b_ready),
    .io_out_0_b_valid(io_in_0_b_valid),
    .io_out_0_b_bits_opcode(io_in_0_b_bits_opcode),
    .io_out_0_b_bits_param(io_in_0_b_bits_param),
    .io_out_0_b_bits_size(io_in_0_b_bits_size),
    .io_out_0_b_bits_source(io_in_0_b_bits_source),
    .io_out_0_b_bits_address(io_in_0_b_bits_address),
    .io_out_0_b_bits_mask(io_in_0_b_bits_mask),
    .io_out_0_b_bits_data(io_in_0_b_bits_data),
    .io_out_0_c_ready(io_in_0_c_ready),
    .io_out_0_c_valid(io_in_0_c_valid),
    .io_out_0_c_bits_opcode(io_in_0_c_bits_opcode),
    .io_out_0_c_bits_param(io_in_0_c_bits_param),
    .io_out_0_c_bits_size(io_in_0_c_bits_size),
    .io_out_0_c_bits_source(io_in_0_c_bits_source),
    .io_out_0_c_bits_address(io_in_0_c_bits_address),
    .io_out_0_c_bits_data(io_in_0_c_bits_data),
    .io_out_0_c_bits_error(io_in_0_c_bits_error),
    .io_out_0_d_ready(io_in_0_d_ready),
    .io_out_0_d_valid(io_in_0_d_valid),
    .io_out_0_d_bits_opcode(io_in_0_d_bits_opcode),
    .io_out_0_d_bits_param(io_in_0_d_bits_param),
    .io_out_0_d_bits_size(io_in_0_d_bits_size),
    .io_out_0_d_bits_source(io_in_0_d_bits_source),
    .io_out_0_d_bits_sink(io_in_0_d_bits_sink),
    .io_out_0_d_bits_addr_lo(io_in_0_d_bits_addr_lo),
    .io_out_0_d_bits_data(io_in_0_d_bits_data),
    .io_out_0_d_bits_error(io_in_0_d_bits_error),
    .io_out_0_e_ready(io_in_0_e_ready),
    .io_out_0_e_valid(io_in_0_e_valid),
    .io_out_0_e_bits_sink(io_in_0_e_bits_sink)
  );

  sirv_tlfragmenter_qspi_1 qspi_TLFragmenter_1 (
    .clock (clk   ),
    .reset (~rst_n),
    .io_in_0_a_ready(io_in_0_a_ready),
    .io_in_0_a_valid(io_in_0_a_valid),
    .io_in_0_a_bits_opcode(io_in_0_a_bits_opcode),
    .io_in_0_a_bits_param(io_in_0_a_bits_param),
    .io_in_0_a_bits_size(io_in_0_a_bits_size),
    .io_in_0_a_bits_source(io_in_0_a_bits_source),
    .io_in_0_a_bits_address(io_in_0_a_bits_address),
    .io_in_0_a_bits_mask(io_in_0_a_bits_mask),
    .io_in_0_a_bits_data(io_in_0_a_bits_data),
    .io_in_0_b_ready(io_in_0_b_ready),
    .io_in_0_b_valid(io_in_0_b_valid),
    .io_in_0_b_bits_opcode(io_in_0_b_bits_opcode),
    .io_in_0_b_bits_param(io_in_0_b_bits_param),
    .io_in_0_b_bits_size(io_in_0_b_bits_size),
    .io_in_0_b_bits_source(io_in_0_b_bits_source),
    .io_in_0_b_bits_address(io_in_0_b_bits_address),
    .io_in_0_b_bits_mask(io_in_0_b_bits_mask),
    .io_in_0_b_bits_data(io_in_0_b_bits_data),
    .io_in_0_c_ready(io_in_0_c_ready),
    .io_in_0_c_valid(io_in_0_c_valid),
    .io_in_0_c_bits_opcode(io_in_0_c_bits_opcode),
    .io_in_0_c_bits_param(io_in_0_c_bits_param),
    .io_in_0_c_bits_size(io_in_0_c_bits_size),
    .io_in_0_c_bits_source(io_in_0_c_bits_source),
    .io_in_0_c_bits_address(io_in_0_c_bits_address),
    .io_in_0_c_bits_data(io_in_0_c_bits_data),
    .io_in_0_c_bits_error(io_in_0_c_bits_error),
    .io_in_0_d_ready(io_in_0_d_ready),
    .io_in_0_d_valid(io_in_0_d_valid),
    .io_in_0_d_bits_opcode(io_in_0_d_bits_opcode),
    .io_in_0_d_bits_param(io_in_0_d_bits_param),
    .io_in_0_d_bits_size(io_in_0_d_bits_size),
    .io_in_0_d_bits_source(io_in_0_d_bits_source),
    .io_in_0_d_bits_sink(io_in_0_d_bits_sink),
    .io_in_0_d_bits_addr_lo(io_in_0_d_bits_addr_lo),
    .io_in_0_d_bits_data(io_in_0_d_bits_data),
    .io_in_0_d_bits_error(io_in_0_d_bits_error),
    .io_in_0_e_ready(io_in_0_e_ready),
    .io_in_0_e_valid(io_in_0_e_valid),
    .io_in_0_e_bits_sink(io_in_0_e_bits_sink),
    .io_out_0_a_ready(io_out_0_a_ready),
    .io_out_0_a_valid(io_out_0_a_valid),
    .io_out_0_a_bits_opcode(io_out_0_a_bits_opcode),
    .io_out_0_a_bits_param(io_out_0_a_bits_param),
    .io_out_0_a_bits_size(io_out_0_a_bits_size),
    .io_out_0_a_bits_source(io_out_0_a_bits_source),
    .io_out_0_a_bits_address(io_out_0_a_bits_address),
    .io_out_0_a_bits_mask(io_out_0_a_bits_mask),
    .io_out_0_a_bits_data(io_out_0_a_bits_data),
    .io_out_0_b_ready(io_out_0_b_ready),
    .io_out_0_b_valid(io_out_0_b_valid),
    .io_out_0_b_bits_opcode(io_out_0_b_bits_opcode),
    .io_out_0_b_bits_param(io_out_0_b_bits_param),
    .io_out_0_b_bits_size(io_out_0_b_bits_size),
    .io_out_0_b_bits_source(io_out_0_b_bits_source),
    .io_out_0_b_bits_address(io_out_0_b_bits_address),
    .io_out_0_b_bits_mask(io_out_0_b_bits_mask),
    .io_out_0_b_bits_data(io_out_0_b_bits_data),
    .io_out_0_c_ready(io_out_0_c_ready),
    .io_out_0_c_valid(io_out_0_c_valid),
    .io_out_0_c_bits_opcode(io_out_0_c_bits_opcode),
    .io_out_0_c_bits_param(io_out_0_c_bits_param),
    .io_out_0_c_bits_size(io_out_0_c_bits_size),
    .io_out_0_c_bits_source(io_out_0_c_bits_source),
    .io_out_0_c_bits_address(io_out_0_c_bits_address),
    .io_out_0_c_bits_data(io_out_0_c_bits_data),
    .io_out_0_c_bits_error(io_out_0_c_bits_error),
    .io_out_0_d_ready(io_out_0_d_ready),
    .io_out_0_d_valid(io_out_0_d_valid),
    .io_out_0_d_bits_opcode(io_out_0_d_bits_opcode),
    .io_out_0_d_bits_param(io_out_0_d_bits_param),
    .io_out_0_d_bits_size(io_out_0_d_bits_size),
    .io_out_0_d_bits_source(io_out_0_d_bits_source),
    .io_out_0_d_bits_sink(io_out_0_d_bits_sink),
    .io_out_0_d_bits_addr_lo(io_out_0_d_bits_addr_lo),
    .io_out_0_d_bits_data(io_out_0_d_bits_data),
    .io_out_0_d_bits_error(io_out_0_d_bits_error),
    .io_out_0_e_ready(io_out_0_e_ready),
    .io_out_0_e_valid(io_out_0_e_valid),
    .io_out_0_e_bits_sink(io_out_0_e_bits_sink)
  );
sirv_flash_qspi u_sirv_flash_qspi(
  .clock                            (clk                              ),
  .reset                            (~rst_n                           ),

  .io_tl_r_0_a_ready                  (io_tl_r_0_a_ready                  ),
  .io_tl_r_0_a_valid                  (io_tl_r_0_a_valid                  ),
  .io_tl_r_0_a_bits_opcode            (io_tl_r_0_a_bits_opcode            ),
  .io_tl_r_0_a_bits_param             (io_tl_r_0_a_bits_param             ),
  .io_tl_r_0_a_bits_size              (io_tl_r_0_a_bits_size              ),
  .io_tl_r_0_a_bits_source            (io_tl_r_0_a_bits_source            ),
  .io_tl_r_0_a_bits_address           (io_tl_r_0_a_bits_address           ),
  .io_tl_r_0_a_bits_mask              (io_tl_r_0_a_bits_mask              ),
  .io_tl_r_0_a_bits_data              (io_tl_r_0_a_bits_data              ),
  .io_tl_r_0_b_ready                  (io_tl_r_0_b_ready                  ),
  .io_tl_r_0_b_valid                  (io_tl_r_0_b_valid                  ),
  .io_tl_r_0_b_bits_opcode            (io_tl_r_0_b_bits_opcode            ),
  .io_tl_r_0_b_bits_param             (io_tl_r_0_b_bits_param             ),
  .io_tl_r_0_b_bits_size              (io_tl_r_0_b_bits_size              ),
  .io_tl_r_0_b_bits_source            (io_tl_r_0_b_bits_source            ),
  .io_tl_r_0_b_bits_address           (io_tl_r_0_b_bits_address           ),
  .io_tl_r_0_b_bits_mask              (io_tl_r_0_b_bits_mask              ),
  .io_tl_r_0_b_bits_data              (io_tl_r_0_b_bits_data              ),
  .io_tl_r_0_c_ready                  (io_tl_r_0_c_ready                  ),
  .io_tl_r_0_c_valid                  (io_tl_r_0_c_valid                  ),
  .io_tl_r_0_c_bits_opcode            (io_tl_r_0_c_bits_opcode            ),
  .io_tl_r_0_c_bits_param             (io_tl_r_0_c_bits_param             ),
  .io_tl_r_0_c_bits_size              (io_tl_r_0_c_bits_size              ),
  .io_tl_r_0_c_bits_source            (io_tl_r_0_c_bits_source            ),
  .io_tl_r_0_c_bits_address           (io_tl_r_0_c_bits_address           ),
  .io_tl_r_0_c_bits_data              (io_tl_r_0_c_bits_data              ),
  .io_tl_r_0_c_bits_error             (io_tl_r_0_c_bits_error             ),
  .io_tl_r_0_d_ready                  (io_tl_r_0_d_ready                  ),
  .io_tl_r_0_d_valid                  (io_tl_r_0_d_valid                  ),
  .io_tl_r_0_d_bits_opcode            (io_tl_r_0_d_bits_opcode            ),
  .io_tl_r_0_d_bits_param             (io_tl_r_0_d_bits_param             ),
  .io_tl_r_0_d_bits_size              (io_tl_r_0_d_bits_size              ),
  .io_tl_r_0_d_bits_source            (io_tl_r_0_d_bits_source            ),
  .io_tl_r_0_d_bits_sink              (io_tl_r_0_d_bits_sink              ),
  .io_tl_r_0_d_bits_addr_lo           (io_tl_r_0_d_bits_addr_lo           ),
  .io_tl_r_0_d_bits_data              (io_tl_r_0_d_bits_data              ),
  .io_tl_r_0_d_bits_error             (io_tl_r_0_d_bits_error             ),
  .io_tl_r_0_e_ready                  (io_tl_r_0_e_ready                  ),
  .io_tl_r_0_e_valid                  (io_tl_r_0_e_valid                  ),
  .io_tl_r_0_e_bits_sink              (io_tl_r_0_e_bits_sink              ),

  .io_tl_f_0_a_ready                  (io_out_0_a_ready                  ),
  .io_tl_f_0_a_valid                  (io_out_0_a_valid                  ),
  .io_tl_f_0_a_bits_opcode            (io_out_0_a_bits_opcode            ),
  .io_tl_f_0_a_bits_param             (io_out_0_a_bits_param             ),
  .io_tl_f_0_a_bits_size              (io_out_0_a_bits_size              ),
  .io_tl_f_0_a_bits_source            (io_out_0_a_bits_source            ),
  .io_tl_f_0_a_bits_address           (io_out_0_a_bits_address           ),
  .io_tl_f_0_a_bits_mask              (io_out_0_a_bits_mask              ),
  .io_tl_f_0_a_bits_data              (io_out_0_a_bits_data              ),
  .io_tl_f_0_b_ready                  (io_out_0_b_ready                  ),
  .io_tl_f_0_b_valid                  (io_out_0_b_valid                  ),
  .io_tl_f_0_b_bits_opcode            (io_out_0_b_bits_opcode            ),
  .io_tl_f_0_b_bits_param             (io_out_0_b_bits_param             ),
  .io_tl_f_0_b_bits_size              (io_out_0_b_bits_size              ),
  .io_tl_f_0_b_bits_source            (io_out_0_b_bits_source            ),
  .io_tl_f_0_b_bits_address           (io_out_0_b_bits_address           ),
  .io_tl_f_0_b_bits_mask              (io_out_0_b_bits_mask              ),
  .io_tl_f_0_b_bits_data              (io_out_0_b_bits_data              ),
  .io_tl_f_0_c_ready                  (io_out_0_c_ready                  ),
  .io_tl_f_0_c_valid                  (io_out_0_c_valid                  ),
  .io_tl_f_0_c_bits_opcode            (io_out_0_c_bits_opcode            ),
  .io_tl_f_0_c_bits_param             (io_out_0_c_bits_param             ),
  .io_tl_f_0_c_bits_size              (io_out_0_c_bits_size              ),
  .io_tl_f_0_c_bits_source            (io_out_0_c_bits_source            ),
  .io_tl_f_0_c_bits_address           (io_out_0_c_bits_address           ),
  .io_tl_f_0_c_bits_data              (io_out_0_c_bits_data              ),
  .io_tl_f_0_c_bits_error             (io_out_0_c_bits_error             ),
  .io_tl_f_0_d_ready                  (io_out_0_d_ready                  ),
  .io_tl_f_0_d_valid                  (io_out_0_d_valid                  ),
  .io_tl_f_0_d_bits_opcode            (io_out_0_d_bits_opcode            ),
  .io_tl_f_0_d_bits_param             (io_out_0_d_bits_param             ),
  .io_tl_f_0_d_bits_size              (io_out_0_d_bits_size              ),
  .io_tl_f_0_d_bits_source            (io_out_0_d_bits_source            ),
  .io_tl_f_0_d_bits_sink              (io_out_0_d_bits_sink              ),
  .io_tl_f_0_d_bits_addr_lo           (io_out_0_d_bits_addr_lo           ),
  .io_tl_f_0_d_bits_data              (io_out_0_d_bits_data              ),
  .io_tl_f_0_d_bits_error             (io_out_0_d_bits_error             ),
  .io_tl_f_0_e_ready                  (io_out_0_e_ready                  ),
  .io_tl_f_0_e_valid                  (io_out_0_e_valid                  ),
  .io_tl_f_0_e_bits_sink              (io_out_0_e_bits_sink              ),


  .io_port_sck       (io_port_sck    ),
  .io_port_dq_0_i    (io_port_dq_0_i ),
  .io_port_dq_0_o    (io_port_dq_0_o ),
  .io_port_dq_0_oe   (io_port_dq_0_oe),
  .io_port_dq_1_i    (io_port_dq_1_i ),
  .io_port_dq_1_o    (io_port_dq_1_o ),
  .io_port_dq_1_oe   (io_port_dq_1_oe),
  .io_port_dq_2_i    (io_port_dq_2_i ),
  .io_port_dq_2_o    (io_port_dq_2_o ),
  .io_port_dq_2_oe   (io_port_dq_2_oe),
  .io_port_dq_3_i    (io_port_dq_3_i ),
  .io_port_dq_3_o    (io_port_dq_3_o ),
  .io_port_dq_3_oe   (io_port_dq_3_oe), 
  .io_port_cs_0      (io_port_cs_0   ),
  .io_tl_i_0_0       (io_tl_i_0_0    ) 

);

endmodule
