riscv-mcu/e203_hbirdv2/rtl/e203/general/sirv_gnrl_icbs.v

 /*                                                                      
 Copyright 2018-2020 Nuclei System Technology, Inc.                
                                                                         
 Licensed under the Apache License, Version 2.0 (the "License");         
 you may not use this file except in compliance with the License.        
 You may obtain a copy of the License at                                 
                                                                         
     http://www.apache.org/licenses/LICENSE-2.0                          
                                                                         
  Unless required by applicable law or agreed to in writing, software    
 distributed under the License is distributed on an "AS IS" BASIS,       
 WITHOUT WARRANTIES OR CONDITIONS OF ANY KIND, either express or implied.
 See the License for the specific language governing permissions and     
 limitations under the License.                                          
 */                                                                      
                                                                         
                                                                         
                                                                         
//=====================================================================
//
// Designer   : Bob Hu
//
// Description:
//  All of the general modules for ICB relevant functions
//
// ====================================================================



// ===========================================================================
//
// Description:
//  The module to handle the ICB bus arbitration
//
// ===========================================================================

module sirv_gnrl_icb_arbt # (
  parameter AW = 32,
  parameter DW = 64,
  parameter USR_W = 1,
  parameter ARBT_SCHEME = 0,//0: priority based; 1: rrobin
  // The number of outstanding transactions supported
  parameter FIFO_OUTS_NUM = 1,
  parameter FIFO_CUT_READY = 0,
  // ARBT_NUM=4 ICB ports, so 2 bits for port id
  parameter ARBT_NUM = 4,
  parameter ALLOW_0CYCL_RSP = 1,
  parameter ARBT_PTR_W = 2
) (
  output             o_icb_cmd_valid, 
  input              o_icb_cmd_ready, 
  output [1-1:0]     o_icb_cmd_read, 
  output [AW-1:0]    o_icb_cmd_addr, 
  output [DW-1:0]    o_icb_cmd_wdata, 
  output [DW/8-1:0]  o_icb_cmd_wmask,
  output [2-1:0]     o_icb_cmd_burst, 
  output [2-1:0]     o_icb_cmd_beat, 
  output             o_icb_cmd_lock,
  output             o_icb_cmd_excl,
  output [1:0]       o_icb_cmd_size,
  output [USR_W-1:0] o_icb_cmd_usr,

  input              o_icb_rsp_valid, 
  output             o_icb_rsp_ready, 
  input              o_icb_rsp_err,
  input              o_icb_rsp_excl_ok,
  input  [DW-1:0]    o_icb_rsp_rdata, 
  input  [USR_W-1:0] o_icb_rsp_usr, 
  
  output [ARBT_NUM*1-1:0]     i_bus_icb_cmd_ready, 
  input  [ARBT_NUM*1-1:0]     i_bus_icb_cmd_valid, 
  input  [ARBT_NUM*1-1:0]     i_bus_icb_cmd_read, 
  input  [ARBT_NUM*AW-1:0]    i_bus_icb_cmd_addr, 
  input  [ARBT_NUM*DW-1:0]    i_bus_icb_cmd_wdata, 
  input  [ARBT_NUM*DW/8-1:0]  i_bus_icb_cmd_wmask,
  input  [ARBT_NUM*2-1:0]     i_bus_icb_cmd_burst,
  input  [ARBT_NUM*2-1:0]     i_bus_icb_cmd_beat ,
  input  [ARBT_NUM*1-1:0]     i_bus_icb_cmd_lock ,
  input  [ARBT_NUM*1-1:0]     i_bus_icb_cmd_excl ,
  input  [ARBT_NUM*2-1:0]     i_bus_icb_cmd_size ,
  input  [ARBT_NUM*USR_W-1:0] i_bus_icb_cmd_usr  ,

  output [ARBT_NUM*1-1:0]     i_bus_icb_rsp_valid, 
  input  [ARBT_NUM*1-1:0]     i_bus_icb_rsp_ready, 
  output [ARBT_NUM*1-1:0]     i_bus_icb_rsp_err,
  output [ARBT_NUM*1-1:0]     i_bus_icb_rsp_excl_ok,
  output [ARBT_NUM*DW-1:0]    i_bus_icb_rsp_rdata, 
  output [ARBT_NUM*USR_W-1:0] i_bus_icb_rsp_usr, 

  input  clk,  
  input  rst_n
  );


integer j;
wire [ARBT_NUM-1:0] i_bus_icb_cmd_grt_vec; 
wire [ARBT_NUM-1:0] i_bus_icb_cmd_sel; 
wire o_icb_cmd_valid_real; 
wire o_icb_cmd_ready_real; 

wire [1-1:0]    i_icb_cmd_read [ARBT_NUM-1:0]; 
wire [AW-1:0]   i_icb_cmd_addr [ARBT_NUM-1:0]; 
wire [DW-1:0]   i_icb_cmd_wdata[ARBT_NUM-1:0]; 
wire [DW/8-1:0] i_icb_cmd_wmask[ARBT_NUM-1:0];
wire [2-1:0]    i_icb_cmd_burst[ARBT_NUM-1:0];
wire [2-1:0]    i_icb_cmd_beat [ARBT_NUM-1:0];
wire [1-1:0]    i_icb_cmd_lock [ARBT_NUM-1:0];
wire [1-1:0]    i_icb_cmd_excl [ARBT_NUM-1:0];
wire [2-1:0]    i_icb_cmd_size [ARBT_NUM-1:0];
wire [USR_W-1:0]i_icb_cmd_usr  [ARBT_NUM-1:0];

reg [1-1:0]    sel_o_icb_cmd_read; 
reg [AW-1:0]   sel_o_icb_cmd_addr; 
reg [DW-1:0]   sel_o_icb_cmd_wdata; 
reg [DW/8-1:0] sel_o_icb_cmd_wmask;
reg [2-1:0]    sel_o_icb_cmd_burst;
reg [2-1:0]    sel_o_icb_cmd_beat ;
reg [1-1:0]    sel_o_icb_cmd_lock ;
reg [1-1:0]    sel_o_icb_cmd_excl ;
reg [2-1:0]    sel_o_icb_cmd_size ;
reg [USR_W-1:0]sel_o_icb_cmd_usr  ;

wire o_icb_rsp_ready_pre; 
wire o_icb_rsp_valid_pre;

wire rspid_fifo_bypass;
wire rspid_fifo_wen;
wire rspid_fifo_ren;

wire [ARBT_PTR_W-1:0] i_icb_rsp_port_id;

wire rspid_fifo_i_valid;
wire rspid_fifo_o_valid;
wire rspid_fifo_i_ready;
wire rspid_fifo_o_ready;
wire [ARBT_PTR_W-1:0] rspid_fifo_rdat;
wire [ARBT_PTR_W-1:0] rspid_fifo_wdat;

wire rspid_fifo_full;       
wire rspid_fifo_empty;       
reg [ARBT_PTR_W-1:0] i_arbt_indic_id;

wire i_icb_cmd_ready_pre;
wire i_icb_cmd_valid_pre;

wire arbt_ena;
    
wire [ARBT_PTR_W-1:0] o_icb_rsp_port_id;

genvar i;
generate //{
  if(ARBT_NUM == 1) begin:arbt_num_eq_1_gen// {
    assign i_bus_icb_cmd_ready = o_icb_cmd_ready    ;
    assign o_icb_cmd_valid     = i_bus_icb_cmd_valid;
    assign o_icb_cmd_read      = i_bus_icb_cmd_read ;
    assign o_icb_cmd_addr      = i_bus_icb_cmd_addr ;
    assign o_icb_cmd_wdata     = i_bus_icb_cmd_wdata;
    assign o_icb_cmd_wmask     = i_bus_icb_cmd_wmask;
    assign o_icb_cmd_burst     = i_bus_icb_cmd_burst;
    assign o_icb_cmd_beat      = i_bus_icb_cmd_beat ;
    assign o_icb_cmd_lock      = i_bus_icb_cmd_lock ;
    assign o_icb_cmd_excl      = i_bus_icb_cmd_excl ;
    assign o_icb_cmd_size      = i_bus_icb_cmd_size ;
    assign o_icb_cmd_usr       = i_bus_icb_cmd_usr  ;
                               
    assign o_icb_rsp_ready     = i_bus_icb_rsp_ready;
    assign i_bus_icb_rsp_valid = o_icb_rsp_valid    ;
    assign i_bus_icb_rsp_err   = o_icb_rsp_err      ;
    assign i_bus_icb_rsp_excl_ok   = o_icb_rsp_excl_ok      ;
    assign i_bus_icb_rsp_rdata = o_icb_rsp_rdata    ;
    assign i_bus_icb_rsp_usr   = o_icb_rsp_usr      ;

  end//}
  else begin:arbt_num_gt_1_gen//{

    assign o_icb_cmd_valid = o_icb_cmd_valid_real & (~rspid_fifo_full);
    assign o_icb_cmd_ready_real = o_icb_cmd_ready & (~rspid_fifo_full); 
    // Distract the icb from the bus declared ports

    for(i = 0; i < ARBT_NUM; i = i+1)//{
    begin:icb_distract_gen
      assign i_icb_cmd_read [i] = i_bus_icb_cmd_read [(i+1)*1     -1 : i*1     ];
      assign i_icb_cmd_addr [i] = i_bus_icb_cmd_addr [(i+1)*AW    -1 : i*AW    ];
      assign i_icb_cmd_wdata[i] = i_bus_icb_cmd_wdata[(i+1)*DW    -1 : i*DW    ];
      assign i_icb_cmd_wmask[i] = i_bus_icb_cmd_wmask[(i+1)*(DW/8)-1 : i*(DW/8)];
      assign i_icb_cmd_burst[i] = i_bus_icb_cmd_burst[(i+1)*2     -1 : i*2     ];
      assign i_icb_cmd_beat [i] = i_bus_icb_cmd_beat [(i+1)*2     -1 : i*2     ];
      assign i_icb_cmd_lock [i] = i_bus_icb_cmd_lock [(i+1)*1     -1 : i*1     ];
      assign i_icb_cmd_excl [i] = i_bus_icb_cmd_excl [(i+1)*1     -1 : i*1     ];
      assign i_icb_cmd_size [i] = i_bus_icb_cmd_size [(i+1)*2     -1 : i*2     ];
      assign i_icb_cmd_usr  [i] = i_bus_icb_cmd_usr  [(i+1)*USR_W -1 : i*USR_W ];

      assign i_bus_icb_cmd_ready[i] = i_bus_icb_cmd_grt_vec[i] & o_icb_cmd_ready_real;
      assign i_bus_icb_rsp_valid[i] = o_icb_rsp_valid_pre & (o_icb_rsp_port_id == i); 
    end//}

    if(ARBT_SCHEME == 0) begin:priorty_arbt//{
      wire arbt_ena = 1'b0;//No use
      for(i = 0; i < ARBT_NUM; i = i+1)//{
      begin:priroty_grt_vec_gen
        if(i==0) begin: i_is_0
          assign i_bus_icb_cmd_grt_vec[i] =  1'b1;
        end
        else begin:i_is_not_0
          assign i_bus_icb_cmd_grt_vec[i] =  ~(|i_bus_icb_cmd_valid[i-1:0]);
        end
        assign i_bus_icb_cmd_sel[i] = i_bus_icb_cmd_grt_vec[i] & i_bus_icb_cmd_valid[i];
      end//}
    end//}
    
    if(ARBT_SCHEME == 1) begin:rrobin_arbt//{
      assign arbt_ena = o_icb_cmd_valid & o_icb_cmd_ready; 
      sirv_gnrl_rrobin # (
          .ARBT_NUM(ARBT_NUM)
      )u_sirv_gnrl_rrobin(
        .grt_vec  (i_bus_icb_cmd_grt_vec),  
        .req_vec  (i_bus_icb_cmd_valid),  
        .arbt_ena (arbt_ena),   
        .clk      (clk),
        .rst_n    (rst_n)
      );
      assign i_bus_icb_cmd_sel = i_bus_icb_cmd_grt_vec;
    end//}


    always @ (*) begin : sel_o_apb_cmd_ready_PROC
      sel_o_icb_cmd_read  = {1   {1'b0}};
      sel_o_icb_cmd_addr  = {AW  {1'b0}};
      sel_o_icb_cmd_wdata = {DW  {1'b0}};
      sel_o_icb_cmd_wmask = {DW/8{1'b0}};
      sel_o_icb_cmd_burst = {2   {1'b0}};
      sel_o_icb_cmd_beat  = {2   {1'b0}};
      sel_o_icb_cmd_lock  = {1   {1'b0}};
      sel_o_icb_cmd_excl  = {1   {1'b0}};
      sel_o_icb_cmd_size  = {2   {1'b0}};
      sel_o_icb_cmd_usr   = {USR_W{1'b0}};
      for(j = 0; j < ARBT_NUM; j = j+1) begin//{
        sel_o_icb_cmd_read  = sel_o_icb_cmd_read  | ({1    {i_bus_icb_cmd_sel[j]}} & i_icb_cmd_read [j]);
        sel_o_icb_cmd_addr  = sel_o_icb_cmd_addr  | ({AW   {i_bus_icb_cmd_sel[j]}} & i_icb_cmd_addr [j]);
        sel_o_icb_cmd_wdata = sel_o_icb_cmd_wdata | ({DW   {i_bus_icb_cmd_sel[j]}} & i_icb_cmd_wdata[j]);
        sel_o_icb_cmd_wmask = sel_o_icb_cmd_wmask | ({DW/8 {i_bus_icb_cmd_sel[j]}} & i_icb_cmd_wmask[j]);
        sel_o_icb_cmd_burst = sel_o_icb_cmd_burst | ({2    {i_bus_icb_cmd_sel[j]}} & i_icb_cmd_burst[j]);
        sel_o_icb_cmd_beat  = sel_o_icb_cmd_beat  | ({2    {i_bus_icb_cmd_sel[j]}} & i_icb_cmd_beat [j]);
        sel_o_icb_cmd_lock  = sel_o_icb_cmd_lock  | ({1    {i_bus_icb_cmd_sel[j]}} & i_icb_cmd_lock [j]);
        sel_o_icb_cmd_excl  = sel_o_icb_cmd_excl  | ({1    {i_bus_icb_cmd_sel[j]}} & i_icb_cmd_excl [j]);
        sel_o_icb_cmd_size  = sel_o_icb_cmd_size  | ({2    {i_bus_icb_cmd_sel[j]}} & i_icb_cmd_size [j]);
        sel_o_icb_cmd_usr   = sel_o_icb_cmd_usr   | ({USR_W{i_bus_icb_cmd_sel[j]}} & i_icb_cmd_usr  [j]);
      end//}
    end
    assign o_icb_cmd_valid_real = |i_bus_icb_cmd_valid; 

    always @ (*) begin : i_arbt_indic_id_PROC
      i_arbt_indic_id = {ARBT_PTR_W{1'b0}};
      for(j = 0; j < ARBT_NUM; j = j+1) begin//{
        i_arbt_indic_id = i_arbt_indic_id | {ARBT_PTR_W{i_bus_icb_cmd_sel[j]}} & $unsigned(j);
      end//}
    end

    assign rspid_fifo_wen = o_icb_cmd_valid & o_icb_cmd_ready;
    assign rspid_fifo_ren = o_icb_rsp_valid & o_icb_rsp_ready;

    
    if(ALLOW_0CYCL_RSP == 1) begin: allow_0rsp
        assign rspid_fifo_bypass = rspid_fifo_empty & rspid_fifo_wen & rspid_fifo_ren;
        assign o_icb_rsp_port_id = rspid_fifo_empty ? rspid_fifo_wdat : rspid_fifo_rdat;
        // We dont need this empty qualifications because we allow the 0 cyle response
        assign o_icb_rsp_valid_pre = o_icb_rsp_valid;
        assign o_icb_rsp_ready     = o_icb_rsp_ready_pre;
    end
    else begin: no_allow_0rsp
        assign rspid_fifo_bypass   = 1'b0;
        assign o_icb_rsp_port_id   = rspid_fifo_empty ? {ARBT_PTR_W{1'b0}} : rspid_fifo_rdat;
        assign o_icb_rsp_valid_pre = (~rspid_fifo_empty) & o_icb_rsp_valid;
        assign o_icb_rsp_ready     = (~rspid_fifo_empty) & o_icb_rsp_ready_pre;
    end

    assign rspid_fifo_i_valid = rspid_fifo_wen & (~rspid_fifo_bypass);
    assign rspid_fifo_full    = (~rspid_fifo_i_ready);
    assign rspid_fifo_o_ready = rspid_fifo_ren & (~rspid_fifo_bypass);
    assign rspid_fifo_empty   = (~rspid_fifo_o_valid);

    assign rspid_fifo_wdat   = i_arbt_indic_id;
 
    if(FIFO_OUTS_NUM == 1) begin:dp_1//{
      sirv_gnrl_pipe_stage # (
        .CUT_READY (FIFO_CUT_READY),
        .DP  (1),
        .DW  (ARBT_PTR_W)
      ) u_sirv_gnrl_rspid_fifo (
        .i_vld(rspid_fifo_i_valid),
        .i_rdy(rspid_fifo_i_ready),
        .i_dat(rspid_fifo_wdat ),
        .o_vld(rspid_fifo_o_valid),
        .o_rdy(rspid_fifo_o_ready),  
        .o_dat(rspid_fifo_rdat ),  
        .clk  (clk),
        .rst_n(rst_n)
      );

    end//}
    else begin: dp_gt1//{
      sirv_gnrl_fifo # (
        .CUT_READY (FIFO_CUT_READY),
        .MSKO      (0),
        .DP  (FIFO_OUTS_NUM),
        .DW  (ARBT_PTR_W)
      ) u_sirv_gnrl_rspid_fifo (
        .i_vld(rspid_fifo_i_valid),
        .i_rdy(rspid_fifo_i_ready),
        .i_dat(rspid_fifo_wdat ),
        .o_vld(rspid_fifo_o_valid),
        .o_rdy(rspid_fifo_o_ready),  
        .o_dat(rspid_fifo_rdat ),  
      
        .clk  (clk),
        .rst_n(rst_n)
      );
    end//}

    assign o_icb_cmd_read  = sel_o_icb_cmd_read ; 
    assign o_icb_cmd_addr  = sel_o_icb_cmd_addr ; 
    assign o_icb_cmd_wdata = sel_o_icb_cmd_wdata; 
    assign o_icb_cmd_wmask = sel_o_icb_cmd_wmask;
    assign o_icb_cmd_burst = sel_o_icb_cmd_burst;
    assign o_icb_cmd_beat  = sel_o_icb_cmd_beat ;
    assign o_icb_cmd_lock  = sel_o_icb_cmd_lock ;
    assign o_icb_cmd_excl  = sel_o_icb_cmd_excl ;
    assign o_icb_cmd_size  = sel_o_icb_cmd_size ;
    assign o_icb_cmd_usr   = sel_o_icb_cmd_usr  ;

    assign o_icb_rsp_ready_pre = i_bus_icb_rsp_ready[o_icb_rsp_port_id]; 



    assign i_bus_icb_rsp_err     = {ARBT_NUM{o_icb_rsp_err  }};  
    assign i_bus_icb_rsp_excl_ok = {ARBT_NUM{o_icb_rsp_excl_ok}};  
    assign i_bus_icb_rsp_rdata   = {ARBT_NUM{o_icb_rsp_rdata}}; 
    assign i_bus_icb_rsp_usr     = {ARBT_NUM{o_icb_rsp_usr}}; 
  end//}
  endgenerate //}

endmodule

// ===========================================================================
//
// Description:
//  The module to handle the ICB bus buffer stages
//
// ===========================================================================

module sirv_gnrl_icb_buffer # (
  parameter OUTS_CNT_W = 1,
  parameter AW = 32,
  parameter DW = 32,
  parameter CMD_CUT_READY = 0,
  parameter RSP_CUT_READY = 0,
  parameter CMD_DP = 0,
  parameter RSP_DP = 0,
  parameter USR_W = 1
) (
  output             icb_buffer_active,

  input              i_icb_cmd_valid, 
  output             i_icb_cmd_ready, 
  input  [1-1:0]     i_icb_cmd_read, 
  input  [AW-1:0]    i_icb_cmd_addr, 
  input  [DW-1:0]    i_icb_cmd_wdata, 
  input  [DW/8-1:0]  i_icb_cmd_wmask,
  input              i_icb_cmd_lock,
  input              i_icb_cmd_excl,
  input  [1:0]       i_icb_cmd_size,
  input  [1:0]       i_icb_cmd_burst,
  input  [1:0]       i_icb_cmd_beat,
  input  [USR_W-1:0] i_icb_cmd_usr,

  output             i_icb_rsp_valid, 
  input              i_icb_rsp_ready, 
  output             i_icb_rsp_err,
  output             i_icb_rsp_excl_ok,
  output [DW-1:0]    i_icb_rsp_rdata, 
  output [USR_W-1:0] i_icb_rsp_usr,
  
  output             o_icb_cmd_valid, 
  input              o_icb_cmd_ready, 
  output [1-1:0]     o_icb_cmd_read, 
  output [AW-1:0]    o_icb_cmd_addr, 
  output [DW-1:0]    o_icb_cmd_wdata, 
  output [DW/8-1:0]  o_icb_cmd_wmask,
  output             o_icb_cmd_lock,
  output             o_icb_cmd_excl,
  output [1:0]       o_icb_cmd_size,
  output [1:0]       o_icb_cmd_burst,
  output [1:0]       o_icb_cmd_beat,
  output [USR_W-1:0] o_icb_cmd_usr,

  input              o_icb_rsp_valid, 
  output             o_icb_rsp_ready, 
  input              o_icb_rsp_err,
  input              o_icb_rsp_excl_ok,
  input  [DW-1:0]    o_icb_rsp_rdata, 
  input  [USR_W-1:0] o_icb_rsp_usr,

  input  clk,  
  input  rst_n
  );

  localparam CMD_PACK_W = (1+AW+DW+(DW/8)+1+1+2+2+2+USR_W);

  wire [CMD_PACK_W-1:0] cmd_fifo_i_dat = {
                                 i_icb_cmd_read, 
                                 i_icb_cmd_addr, 
                                 i_icb_cmd_wdata, 
                                 i_icb_cmd_wmask,
                                 i_icb_cmd_lock,
                                 i_icb_cmd_excl,
                                 i_icb_cmd_size,
                                 i_icb_cmd_burst,
                                 i_icb_cmd_beat,
                                 i_icb_cmd_usr};

  wire [CMD_PACK_W-1:0] cmd_fifo_o_dat;

  assign {
                                 o_icb_cmd_read, 
                                 o_icb_cmd_addr, 
                                 o_icb_cmd_wdata, 
                                 o_icb_cmd_wmask,
                                 o_icb_cmd_lock,
                                 o_icb_cmd_excl,
                                 o_icb_cmd_size,
                                 o_icb_cmd_burst,
                                 o_icb_cmd_beat,
                                 o_icb_cmd_usr} = cmd_fifo_o_dat;
  sirv_gnrl_fifo # (
    .CUT_READY (CMD_CUT_READY),
    .MSKO      (0),
    .DP  (CMD_DP),
    .DW  (CMD_PACK_W)
  ) u_sirv_gnrl_cmd_fifo (
    .i_vld(i_icb_cmd_valid),
    .i_rdy(i_icb_cmd_ready),
    .i_dat(cmd_fifo_i_dat ),
    .o_vld(o_icb_cmd_valid),
    .o_rdy(o_icb_cmd_ready),  
    .o_dat(cmd_fifo_o_dat ),  
  
    .clk  (clk),
    .rst_n(rst_n)
  );


  localparam RSP_PACK_W = (2+DW+USR_W);
  wire [RSP_PACK_W-1:0] rsp_fifo_i_dat = {
                                 o_icb_rsp_err,
                                 o_icb_rsp_excl_ok,
                                 o_icb_rsp_rdata, 
                                 o_icb_rsp_usr};

  wire [RSP_PACK_W-1:0] rsp_fifo_o_dat;

  assign {
                                 i_icb_rsp_err,
                                 i_icb_rsp_excl_ok,
                                 i_icb_rsp_rdata, 
                                 i_icb_rsp_usr} = rsp_fifo_o_dat;
  sirv_gnrl_fifo # (
    .CUT_READY (RSP_CUT_READY),
    .MSKO      (0),
    .DP  (RSP_DP),
    .DW  (RSP_PACK_W)
  ) u_sirv_gnrl_rsp_fifo (
    .i_vld(o_icb_rsp_valid),
    .i_rdy(o_icb_rsp_ready),
    .i_dat(rsp_fifo_i_dat ),
    .o_vld(i_icb_rsp_valid),
    .o_rdy(i_icb_rsp_ready),  
    .o_dat(rsp_fifo_o_dat ),  
  
    .clk  (clk),
    .rst_n(rst_n)
  );

  wire outs_cnt_inc = i_icb_cmd_valid & i_icb_cmd_ready;
  wire outs_cnt_dec = i_icb_rsp_valid & i_icb_rsp_ready;
     // If meanwhile no or have set and clear, then no changes
  wire outs_cnt_ena = outs_cnt_inc ^ outs_cnt_dec;
     // If only inc or only dec
  wire outs_cnt_r;
  wire outs_cnt_nxt = outs_cnt_inc ? (outs_cnt_r + 1'b1) : (outs_cnt_r - 1'b1);
  sirv_gnrl_dfflr #(OUTS_CNT_W) outs_cnt_dfflr (outs_cnt_ena, outs_cnt_nxt, outs_cnt_r, clk, rst_n);

  assign icb_buffer_active = i_icb_cmd_valid | (~(outs_cnt_r == {OUTS_CNT_W{1'b0}}));

endmodule

// ===========================================================================
//
// Description:
//  The module to handle the ICB bus width conversion from 32bits to 64bits
//
// ===========================================================================

module sirv_gnrl_icb_n2w # (
  parameter AW = 32,
  parameter USR_W = 1,
  parameter FIFO_OUTS_NUM = 8,
  parameter FIFO_CUT_READY = 0,
  parameter X_W = 32,
  parameter Y_W = 64
) (
  input              i_icb_cmd_valid, 
  output             i_icb_cmd_ready, 
  input  [1-1:0]     i_icb_cmd_read, 
  input  [AW-1:0]    i_icb_cmd_addr, 
  input  [X_W-1:0]   i_icb_cmd_wdata, 
  input  [X_W/8-1:0] i_icb_cmd_wmask,
  input              i_icb_cmd_lock,
  input              i_icb_cmd_excl,
  input  [1:0]       i_icb_cmd_size,
  input  [1:0]       i_icb_cmd_burst,
  input  [1:0]       i_icb_cmd_beat,
  input  [USR_W-1:0] i_icb_cmd_usr,

  output             i_icb_rsp_valid, 
  input              i_icb_rsp_ready, 
  output             i_icb_rsp_err,
  output             i_icb_rsp_excl_ok,
  output [X_W-1:0]   i_icb_rsp_rdata, 
  output [USR_W-1:0] i_icb_rsp_usr,
  
  output             o_icb_cmd_valid, 
  input              o_icb_cmd_ready, 
  output [1-1:0]     o_icb_cmd_read, 
  output [AW-1:0]    o_icb_cmd_addr, 
  output [Y_W-1:0]   o_icb_cmd_wdata, 
  output [Y_W/8-1:0] o_icb_cmd_wmask,
  output             o_icb_cmd_lock,
  output             o_icb_cmd_excl,
  output [1:0]       o_icb_cmd_size,
  output [1:0]       o_icb_cmd_burst,
  output [1:0]       o_icb_cmd_beat,
  output [USR_W-1:0] o_icb_cmd_usr,

  input              o_icb_rsp_valid, 
  output             o_icb_rsp_ready, 
  input              o_icb_rsp_err,
  input              o_icb_rsp_excl_ok,
  input  [Y_W-1:0]   o_icb_rsp_rdata, 
  input  [USR_W-1:0] o_icb_rsp_usr,

  input  clk,  
  input  rst_n
  );


    wire cmd_y_lo_hi;
    wire rsp_y_lo_hi;
        
    wire n2w_fifo_wen = i_icb_cmd_valid & i_icb_cmd_ready;
    wire n2w_fifo_ren = i_icb_rsp_valid & i_icb_rsp_ready;

    wire n2w_fifo_i_ready;
    wire n2w_fifo_i_valid = n2w_fifo_wen;
    wire n2w_fifo_full    = (~n2w_fifo_i_ready);
    wire n2w_fifo_o_valid ;
    wire n2w_fifo_o_ready = n2w_fifo_ren;
    wire n2w_fifo_empty   = (~n2w_fifo_o_valid);

  generate
    if(FIFO_OUTS_NUM == 1) begin:fifo_dp_1//{
      sirv_gnrl_pipe_stage # (
        .CUT_READY (FIFO_CUT_READY),
        .DP  (1),
        .DW  (1)
      ) u_sirv_gnrl_n2w_fifo (
        .i_vld(n2w_fifo_i_valid),
        .i_rdy(n2w_fifo_i_ready),
        .i_dat(cmd_y_lo_hi ),
        .o_vld(n2w_fifo_o_valid),
        .o_rdy(n2w_fifo_o_ready),  
        .o_dat(rsp_y_lo_hi ),  
      
        .clk  (clk),
        .rst_n(rst_n)
      );

    end//}
    else begin: fifo_dp_gt_1//{
      sirv_gnrl_fifo # (
        .CUT_READY (FIFO_CUT_READY),
        .MSKO      (0),
        .DP  (FIFO_OUTS_NUM),
        .DW  (1)
      ) u_sirv_gnrl_n2w_fifo (
        .i_vld(n2w_fifo_i_valid),
        .i_rdy(n2w_fifo_i_ready),
        .i_dat(cmd_y_lo_hi ),
        .o_vld(n2w_fifo_o_valid),
        .o_rdy(n2w_fifo_o_ready),  
        .o_dat(rsp_y_lo_hi ),  
      
        .clk  (clk),
        .rst_n(rst_n)
      );
    end//}
  endgenerate



  generate
    if(X_W == 32) begin: x_w_32//{
      if(Y_W == 64) begin: y_w_64//{
        assign cmd_y_lo_hi = i_icb_cmd_addr[2]; 
      end//}
    end//}
  endgenerate

  assign o_icb_cmd_valid = (~n2w_fifo_full) & i_icb_cmd_valid; 
  assign i_icb_cmd_ready = (~n2w_fifo_full) & o_icb_cmd_ready; 
  assign o_icb_cmd_read  = i_icb_cmd_read ;
  assign o_icb_cmd_addr  = i_icb_cmd_addr ;
  assign o_icb_cmd_lock  = i_icb_cmd_lock ;
  assign o_icb_cmd_excl  = i_icb_cmd_excl ;
  assign o_icb_cmd_size  = i_icb_cmd_size ;
  assign o_icb_cmd_burst = i_icb_cmd_burst;
  assign o_icb_cmd_beat  = i_icb_cmd_beat ;
  assign o_icb_cmd_usr   = i_icb_cmd_usr  ;

  assign o_icb_cmd_wdata = {i_icb_cmd_wdata,i_icb_cmd_wdata};
  assign o_icb_cmd_wmask = cmd_y_lo_hi ?  {i_icb_cmd_wmask,  {X_W/8{1'b0}}} : {  {X_W/8{1'b0}},i_icb_cmd_wmask};

  assign i_icb_rsp_valid = o_icb_rsp_valid ;
  assign i_icb_rsp_err   = o_icb_rsp_err   ;
  assign i_icb_rsp_excl_ok   = o_icb_rsp_excl_ok   ;
  assign i_icb_rsp_rdata = rsp_y_lo_hi ?  o_icb_rsp_rdata[Y_W-1:X_W] : o_icb_rsp_rdata[X_W-1:0] ;
  assign i_icb_rsp_usr   = o_icb_rsp_usr   ;
  assign o_icb_rsp_ready = i_icb_rsp_ready;  

endmodule

// ===========================================================================
//
// Description:
//  The module to handle the ICB bus de-mux
//
// ===========================================================================

module sirv_gnrl_icb_splt # (
  parameter AW = 32,
  parameter DW = 64,
  // The number of outstanding supported
  parameter FIFO_OUTS_NUM = 8,
  parameter FIFO_CUT_READY = 0,
  // SPLT_NUM=4 ports, so 2 bits for port id
  parameter SPLT_NUM = 4,
  parameter SPLT_PTR_1HOT = 1,// Currently we always use 1HOT (i.e., this is configured as 1)
                                // do not try to configure it as 0, becuase we never use it and verify it
  parameter SPLT_PTR_W = 4,
  parameter ALLOW_DIFF = 1,
  parameter ALLOW_0CYCL_RSP = 1,
  parameter VLD_MSK_PAYLOAD = 0,
  parameter USR_W = 1 
) (
  input  [SPLT_NUM-1:0] i_icb_splt_indic,        

  input  i_icb_cmd_valid, 
  output i_icb_cmd_ready, 
  input  [1-1:0]    i_icb_cmd_read, 
  input  [AW-1:0]   i_icb_cmd_addr, 
  input  [DW-1:0]   i_icb_cmd_wdata, 
  input  [DW/8-1:0] i_icb_cmd_wmask,
  input  [1:0]      i_icb_cmd_burst,
  input  [1:0]      i_icb_cmd_beat,
  input             i_icb_cmd_lock,
  input             i_icb_cmd_excl,
  input  [1:0]      i_icb_cmd_size,
  input  [USR_W-1:0]i_icb_cmd_usr,

  output i_icb_rsp_valid, 
  input  i_icb_rsp_ready, 
  output i_icb_rsp_err,
  output i_icb_rsp_excl_ok,
  output [DW-1:0] i_icb_rsp_rdata, 
  output [USR_W-1:0] i_icb_rsp_usr, 
  
  input  [SPLT_NUM*1-1:0]    o_bus_icb_cmd_ready, 
  output [SPLT_NUM*1-1:0]    o_bus_icb_cmd_valid, 
  output [SPLT_NUM*1-1:0]    o_bus_icb_cmd_read, 
  output [SPLT_NUM*AW-1:0]   o_bus_icb_cmd_addr, 
  output [SPLT_NUM*DW-1:0]   o_bus_icb_cmd_wdata, 
  output [SPLT_NUM*DW/8-1:0] o_bus_icb_cmd_wmask,
  output [SPLT_NUM*2-1:0]    o_bus_icb_cmd_burst,
  output [SPLT_NUM*2-1:0]    o_bus_icb_cmd_beat,
  output [SPLT_NUM*1-1:0]    o_bus_icb_cmd_lock,
  output [SPLT_NUM*1-1:0]    o_bus_icb_cmd_excl,
  output [SPLT_NUM*2-1:0]    o_bus_icb_cmd_size,
  output [SPLT_NUM*USR_W-1:0]o_bus_icb_cmd_usr,

  input  [SPLT_NUM*1-1:0]  o_bus_icb_rsp_valid, 
  output [SPLT_NUM*1-1:0]  o_bus_icb_rsp_ready, 
  input  [SPLT_NUM*1-1:0]  o_bus_icb_rsp_err,
  input  [SPLT_NUM*1-1:0]  o_bus_icb_rsp_excl_ok,
  input  [SPLT_NUM*DW-1:0] o_bus_icb_rsp_rdata, 
  input  [SPLT_NUM*USR_W-1:0] o_bus_icb_rsp_usr, 

  input  clk,  
  input  rst_n
  );


integer j;

wire [SPLT_NUM-1:0] o_icb_cmd_valid; 
wire [SPLT_NUM-1:0] o_icb_cmd_ready; 

wire [1-1:0]    o_icb_cmd_read [SPLT_NUM-1:0]; 
wire [AW-1:0]   o_icb_cmd_addr [SPLT_NUM-1:0]; 
wire [DW-1:0]   o_icb_cmd_wdata[SPLT_NUM-1:0]; 
wire [DW/8-1:0] o_icb_cmd_wmask[SPLT_NUM-1:0];
wire [1:0]      o_icb_cmd_burst[SPLT_NUM-1:0];
wire [1:0]      o_icb_cmd_beat [SPLT_NUM-1:0];
wire            o_icb_cmd_lock [SPLT_NUM-1:0];
wire            o_icb_cmd_excl [SPLT_NUM-1:0];
wire [1:0]      o_icb_cmd_size [SPLT_NUM-1:0];
wire [USR_W-1:0]o_icb_cmd_usr  [SPLT_NUM-1:0];

wire [SPLT_NUM-1:0] o_icb_rsp_valid; 
wire [SPLT_NUM-1:0] o_icb_rsp_ready; 
wire [SPLT_NUM-1:0] o_icb_rsp_err  ;
wire [SPLT_NUM-1:0] o_icb_rsp_excl_ok  ;
wire [DW-1:0] o_icb_rsp_rdata  [SPLT_NUM-1:0];
wire [USR_W-1:0] o_icb_rsp_usr [SPLT_NUM-1:0];

reg sel_o_apb_cmd_ready;

wire rspid_fifo_bypass;
wire rspid_fifo_wen;
wire rspid_fifo_ren;

wire [SPLT_PTR_W-1:0] o_icb_rsp_port_id;

wire rspid_fifo_i_valid;
wire rspid_fifo_o_valid;
wire rspid_fifo_i_ready;
wire rspid_fifo_o_ready;
wire [SPLT_PTR_W-1:0] rspid_fifo_rdat;
wire [SPLT_PTR_W-1:0] rspid_fifo_wdat;

wire rspid_fifo_full;       
wire rspid_fifo_empty;       
reg [SPLT_PTR_W-1:0] i_splt_indic_id;

wire i_icb_cmd_ready_pre;
wire i_icb_cmd_valid_pre;
    
wire i_icb_rsp_ready_pre; 
wire i_icb_rsp_valid_pre;


genvar i;
generate //{
  if(SPLT_NUM == 1) begin:splt_num_eq_1_gen// {
    assign i_icb_cmd_ready     = o_bus_icb_cmd_ready; 
    assign o_bus_icb_cmd_valid = i_icb_cmd_valid; 
    assign o_bus_icb_cmd_read  = i_icb_cmd_read ; 
    assign o_bus_icb_cmd_addr  = i_icb_cmd_addr ; 
    assign o_bus_icb_cmd_wdata = i_icb_cmd_wdata; 
    assign o_bus_icb_cmd_wmask = i_icb_cmd_wmask;
    assign o_bus_icb_cmd_burst = i_icb_cmd_burst;
    assign o_bus_icb_cmd_beat  = i_icb_cmd_beat ;
    assign o_bus_icb_cmd_lock  = i_icb_cmd_lock ;
    assign o_bus_icb_cmd_excl  = i_icb_cmd_excl ;
    assign o_bus_icb_cmd_size  = i_icb_cmd_size ;
    assign o_bus_icb_cmd_usr   = i_icb_cmd_usr  ;

    assign o_bus_icb_rsp_ready = i_icb_rsp_ready; 
    assign i_icb_rsp_valid     = o_bus_icb_rsp_valid; 
    assign i_icb_rsp_err       = o_bus_icb_rsp_err  ;
    assign i_icb_rsp_excl_ok   = o_bus_icb_rsp_excl_ok  ;
    assign i_icb_rsp_rdata     = o_bus_icb_rsp_rdata;
    assign i_icb_rsp_usr       = o_bus_icb_rsp_usr;

  end//}
  else begin:splt_num_gt_1_gen//{

    for(i = 0; i < SPLT_NUM; i = i+1)//{
    begin:icb_distract_gen
      assign o_icb_cmd_ready[i]                             = o_bus_icb_cmd_ready[(i+1)*1     -1 : (i)*1     ]; 
      assign o_bus_icb_cmd_valid[(i+1)*1     -1 : i*1     ] = o_icb_cmd_valid[i];
      assign o_bus_icb_cmd_read [(i+1)*1     -1 : i*1     ] = o_icb_cmd_read [i];
      assign o_bus_icb_cmd_addr [(i+1)*AW    -1 : i*AW    ] = o_icb_cmd_addr [i];
      assign o_bus_icb_cmd_wdata[(i+1)*DW    -1 : i*DW    ] = o_icb_cmd_wdata[i];
      assign o_bus_icb_cmd_wmask[(i+1)*(DW/8)-1 : i*(DW/8)] = o_icb_cmd_wmask[i];
      assign o_bus_icb_cmd_burst[(i+1)*2     -1 : i*2     ] = o_icb_cmd_burst[i];
      assign o_bus_icb_cmd_beat [(i+1)*2     -1 : i*2     ] = o_icb_cmd_beat [i];
      assign o_bus_icb_cmd_lock [(i+1)*1     -1 : i*1     ] = o_icb_cmd_lock [i];
      assign o_bus_icb_cmd_excl [(i+1)*1     -1 : i*1     ] = o_icb_cmd_excl [i];
      assign o_bus_icb_cmd_size [(i+1)*2     -1 : i*2     ] = o_icb_cmd_size [i];
      assign o_bus_icb_cmd_usr  [(i+1)*USR_W -1 : i*USR_W ] = o_icb_cmd_usr  [i];

      assign o_bus_icb_rsp_ready[(i+1)*1-1 :i*1 ] = o_icb_rsp_ready[i]; 
      assign o_icb_rsp_valid[i]                   = o_bus_icb_rsp_valid[(i+1)*1-1 :i*1 ]; 
      assign o_icb_rsp_err  [i]                   = o_bus_icb_rsp_err  [(i+1)*1-1 :i*1 ];
      assign o_icb_rsp_excl_ok  [i]               = o_bus_icb_rsp_excl_ok  [(i+1)*1-1 :i*1 ];
      assign o_icb_rsp_rdata[i]                   = o_bus_icb_rsp_rdata[(i+1)*DW-1:i*DW];
      assign o_icb_rsp_usr  [i]                   = o_bus_icb_rsp_usr  [(i+1)*USR_W-1:i*USR_W];
    end//}

    ///////////////////////
    // Input ICB will be accepted when
    // (*) The targeted icb have "ready" asserted
    // (*) The FIFO is not full
    
    always @ (*) begin : sel_o_apb_cmd_ready_PROC
      sel_o_apb_cmd_ready = 1'b0;
      for(j = 0; j < SPLT_NUM; j = j+1) begin//{
        sel_o_apb_cmd_ready = sel_o_apb_cmd_ready | (i_icb_splt_indic[j] & o_icb_cmd_ready[j]);
      end//}
    end

    assign i_icb_cmd_ready_pre = sel_o_apb_cmd_ready;

    if(ALLOW_DIFF == 1) begin:allow_diff// {
       assign i_icb_cmd_valid_pre = i_icb_cmd_valid     & (~rspid_fifo_full);
       assign i_icb_cmd_ready     = i_icb_cmd_ready_pre & (~rspid_fifo_full);
    end
    else begin:not_allow_diff
       // The next transaction can only be issued if there is no any outstanding 
       //   transactions to different targets
       wire cmd_diff_branch = (~rspid_fifo_empty) & (~(rspid_fifo_wdat == rspid_fifo_rdat));
       assign i_icb_cmd_valid_pre = i_icb_cmd_valid     & (~cmd_diff_branch) & (~rspid_fifo_full);
       assign i_icb_cmd_ready     = i_icb_cmd_ready_pre & (~cmd_diff_branch) & (~rspid_fifo_full);
    end
    
    if(SPLT_PTR_1HOT == 1) begin:ptr_1hot// {
       always @ (*) begin : i_splt_indic_id_PROC
         i_splt_indic_id = i_icb_splt_indic;
       end
    end
    else begin:ptr_not_1hot//}{
       always @ (*) begin : i_splt_indic_id_PROC
         i_splt_indic_id = {SPLT_PTR_W{1'b0}};
         for(j = 0; j < SPLT_NUM; j = j+1) begin//{
           i_splt_indic_id = i_splt_indic_id | ({SPLT_PTR_W{i_icb_splt_indic[j]}} & $unsigned(j));
         end//}
       end
    end//}
        
    assign rspid_fifo_wen = i_icb_cmd_valid & i_icb_cmd_ready;
    assign rspid_fifo_ren = i_icb_rsp_valid & i_icb_rsp_ready;

    if(ALLOW_0CYCL_RSP == 1) begin: allow_0rsp
        assign rspid_fifo_bypass = rspid_fifo_empty & rspid_fifo_wen & rspid_fifo_ren;
        assign o_icb_rsp_port_id = rspid_fifo_empty ? rspid_fifo_wdat : rspid_fifo_rdat;
        // We dont need this empty qualifications because we allow the 0 cyle response
        assign i_icb_rsp_valid     = i_icb_rsp_valid_pre;
        assign i_icb_rsp_ready_pre = i_icb_rsp_ready;
    end
    else begin: no_allow_0rsp
        assign rspid_fifo_bypass = 1'b0;
        assign o_icb_rsp_port_id = rspid_fifo_empty ? {SPLT_PTR_W{1'b0}} : rspid_fifo_rdat;
        assign i_icb_rsp_valid     = (~rspid_fifo_empty) & i_icb_rsp_valid_pre;
        assign i_icb_rsp_ready_pre = (~rspid_fifo_empty) & i_icb_rsp_ready;
    end

    assign rspid_fifo_i_valid = rspid_fifo_wen & (~rspid_fifo_bypass);
    assign rspid_fifo_full    = (~rspid_fifo_i_ready);
    assign rspid_fifo_o_ready = rspid_fifo_ren & (~rspid_fifo_bypass);
    assign rspid_fifo_empty   = (~rspid_fifo_o_valid);

    assign rspid_fifo_wdat   = i_splt_indic_id;
 
    if(FIFO_OUTS_NUM == 1) begin:fifo_dp_1//{
      sirv_gnrl_pipe_stage # (
        .CUT_READY (FIFO_CUT_READY),
        .DP  (1),
        .DW  (SPLT_PTR_W)
      ) u_sirv_gnrl_rspid_fifo (
        .i_vld(rspid_fifo_i_valid),
        .i_rdy(rspid_fifo_i_ready),
        .i_dat(rspid_fifo_wdat ),
        .o_vld(rspid_fifo_o_valid),
        .o_rdy(rspid_fifo_o_ready),  
        .o_dat(rspid_fifo_rdat ),  
      
        .clk  (clk),
        .rst_n(rst_n)
      );

    end//}
    else begin: fifo_dp_gt_1//{
      sirv_gnrl_fifo # (
        .CUT_READY (FIFO_CUT_READY),
        .MSKO      (0),
        .DP  (FIFO_OUTS_NUM),
        .DW  (SPLT_PTR_W)
      ) u_sirv_gnrl_rspid_fifo (
        .i_vld(rspid_fifo_i_valid),
        .i_rdy(rspid_fifo_i_ready),
        .i_dat(rspid_fifo_wdat ),
        .o_vld(rspid_fifo_o_valid),
        .o_rdy(rspid_fifo_o_ready),  
        .o_dat(rspid_fifo_rdat ),  
      
        .clk  (clk),
        .rst_n(rst_n)
      );
    end//}

    ///////////////////////
    // 
    for(i = 0; i < SPLT_NUM; i = i+1)//{
    begin:o_icb_cmd_valid_gen
      assign o_icb_cmd_valid[i] = i_icb_splt_indic[i] & i_icb_cmd_valid_pre;         
      if(VLD_MSK_PAYLOAD == 0) begin: no_vld_msk_payload
          assign o_icb_cmd_read [i] = i_icb_cmd_read ;
          assign o_icb_cmd_addr [i] = i_icb_cmd_addr ;
          assign o_icb_cmd_wdata[i] = i_icb_cmd_wdata;
          assign o_icb_cmd_wmask[i] = i_icb_cmd_wmask;
          assign o_icb_cmd_burst[i] = i_icb_cmd_burst;
          assign o_icb_cmd_beat [i] = i_icb_cmd_beat ;
          assign o_icb_cmd_lock [i] = i_icb_cmd_lock ;
          assign o_icb_cmd_excl [i] = i_icb_cmd_excl ;
          assign o_icb_cmd_size [i] = i_icb_cmd_size ;
          assign o_icb_cmd_usr  [i] = i_icb_cmd_usr  ;
      end
      else begin: vld_msk_payload
          assign o_icb_cmd_read [i] = {1    {o_icb_cmd_valid[i]}} & i_icb_cmd_read ;
          assign o_icb_cmd_addr [i] = {AW   {o_icb_cmd_valid[i]}} & i_icb_cmd_addr ;
          assign o_icb_cmd_wdata[i] = {DW   {o_icb_cmd_valid[i]}} & i_icb_cmd_wdata;
          assign o_icb_cmd_wmask[i] = {DW/8 {o_icb_cmd_valid[i]}} & i_icb_cmd_wmask;
          assign o_icb_cmd_burst[i] = {2    {o_icb_cmd_valid[i]}} & i_icb_cmd_burst;
          assign o_icb_cmd_beat [i] = {2    {o_icb_cmd_valid[i]}} & i_icb_cmd_beat ;
          assign o_icb_cmd_lock [i] = {1    {o_icb_cmd_valid[i]}} & i_icb_cmd_lock ;
          assign o_icb_cmd_excl [i] = {1    {o_icb_cmd_valid[i]}} & i_icb_cmd_excl ;
          assign o_icb_cmd_size [i] = {2    {o_icb_cmd_valid[i]}} & i_icb_cmd_size ;
          assign o_icb_cmd_usr  [i] = {USR_W{o_icb_cmd_valid[i]}} & i_icb_cmd_usr  ;
      end
    end//}
    //
    
    ///////////////////////
    // 
    //
    if(SPLT_PTR_1HOT == 1) begin:ptr_1hot_rsp// {

        for(i = 0; i < SPLT_NUM; i = i+1)//{
        begin:o_icb_rsp_ready_gen
          assign o_icb_rsp_ready[i] = (o_icb_rsp_port_id[i] & i_icb_rsp_ready_pre);
        end//}
        //
        assign i_icb_rsp_valid_pre = |(o_icb_rsp_valid & o_icb_rsp_port_id);


        reg sel_i_icb_rsp_err;
        reg sel_i_icb_rsp_excl_ok;
        reg [DW-1:0] sel_i_icb_rsp_rdata; 
        reg [USR_W-1:0] sel_i_icb_rsp_usr; 

        always @ (*) begin : sel_icb_rsp_PROC
          sel_i_icb_rsp_err   = 1'b0;
          sel_i_icb_rsp_excl_ok   = 1'b0;
          sel_i_icb_rsp_rdata = {DW   {1'b0}};
          sel_i_icb_rsp_usr   = {USR_W{1'b0}};
          for(j = 0; j < SPLT_NUM; j = j+1) begin//{
            sel_i_icb_rsp_err     = sel_i_icb_rsp_err     | (       o_icb_rsp_port_id[j]   & o_icb_rsp_err[j]);
            sel_i_icb_rsp_excl_ok = sel_i_icb_rsp_excl_ok | (       o_icb_rsp_port_id[j]   & o_icb_rsp_excl_ok[j]);
            sel_i_icb_rsp_rdata   = sel_i_icb_rsp_rdata   | ({DW   {o_icb_rsp_port_id[j]}} & o_icb_rsp_rdata[j]);
            sel_i_icb_rsp_usr     = sel_i_icb_rsp_usr     | ({USR_W{o_icb_rsp_port_id[j]}} & o_icb_rsp_usr[j]);
          end//}
        end

        assign i_icb_rsp_err   = sel_i_icb_rsp_err  ;
        assign i_icb_rsp_excl_ok   = sel_i_icb_rsp_excl_ok  ;
        assign i_icb_rsp_rdata = sel_i_icb_rsp_rdata;
        assign i_icb_rsp_usr   = sel_i_icb_rsp_usr  ;

    end
    else begin:ptr_not_1hot_rsp//}{

        for(i = 0; i < SPLT_NUM; i = i+1)//{
        begin:o_icb_rsp_ready_gen
          assign o_icb_rsp_ready[i] = (o_icb_rsp_port_id == i) & i_icb_rsp_ready_pre;
        end//}
        //
        assign i_icb_rsp_valid_pre = o_icb_rsp_valid[o_icb_rsp_port_id]; 


        assign i_icb_rsp_err     = o_icb_rsp_err    [o_icb_rsp_port_id]; 
        assign i_icb_rsp_excl_ok = o_icb_rsp_excl_ok[o_icb_rsp_port_id]; 
        assign i_icb_rsp_rdata   = o_icb_rsp_rdata  [o_icb_rsp_port_id]; 
        assign i_icb_rsp_usr     = o_icb_rsp_usr    [o_icb_rsp_port_id]; 
    end//}
    
  end//}
  endgenerate //}

endmodule

// ===========================================================================
//
// Description:
//  The module to handle the simple-ICB bus to AXI bus conversion 
//
// ===========================================================================

module sirv_gnrl_icb2axi # (
  parameter AXI_FIFO_DP = 0, // This is to optionally add the pipeline stage for AXI bus
                             //   if the depth is 0, then means pass through, not add pipeline
                             //   if the depth is 2, then means added one ping-pong buffer stage
  parameter AXI_FIFO_CUT_READY = 1, // This is to cut the back-pressure signal if you set as 1
  parameter AW = 32,
  parameter FIFO_OUTS_NUM = 8,
  parameter FIFO_CUT_READY = 0,
  parameter DW = 64 // 64 or 32 bits
) (
  input              i_icb_cmd_valid, 
  output             i_icb_cmd_ready, 
  input  [1-1:0]     i_icb_cmd_read, 
  input  [AW-1:0]    i_icb_cmd_addr, 
  input  [DW-1:0]    i_icb_cmd_wdata, 
  input  [DW/8-1:0]  i_icb_cmd_wmask,
  input  [1:0]       i_icb_cmd_size,

  output             i_icb_rsp_valid, 
  input              i_icb_rsp_ready, 
  output             i_icb_rsp_err,
  output [DW-1:0]    i_icb_rsp_rdata, 
  
  output o_axi_arvalid,
  input  o_axi_arready,
  output [AW-1:0] o_axi_araddr,
  output [3:0] o_axi_arcache,
  output [2:0] o_axi_arprot,
  output [1:0] o_axi_arlock,
  output [1:0] o_axi_arburst,
  output [3:0] o_axi_arlen,
  output [2:0] o_axi_arsize,

  output o_axi_awvalid,
  input  o_axi_awready,
  output [AW-1:0] o_axi_awaddr,
  output [3:0] o_axi_awcache,
  output [2:0] o_axi_awprot,
  output [1:0] o_axi_awlock,
  output [1:0] o_axi_awburst,
  output [3:0] o_axi_awlen,
  output [2:0] o_axi_awsize,

  input  o_axi_rvalid,
  output o_axi_rready,
  input  [DW-1:0] o_axi_rdata,
  input  [1:0] o_axi_rresp,
  input  o_axi_rlast,

  output o_axi_wvalid,
  input  o_axi_wready,
  output [DW-1:0] o_axi_wdata,
  output [(DW/8)-1:0] o_axi_wstrb,
  output o_axi_wlast,

  input  o_axi_bvalid,
  output o_axi_bready,
  input  [1:0] o_axi_bresp,

  input  clk,  
  input  rst_n
  );

  wire i_axi_arvalid;
  wire i_axi_arready;
  wire [AW-1:0] i_axi_araddr;
  wire [3:0] i_axi_arcache;
  wire [2:0] i_axi_arprot;
  wire [1:0] i_axi_arlock;
  wire [1:0] i_axi_arburst;
  wire [3:0] i_axi_arlen;
  wire [2:0] i_axi_arsize;

  wire i_axi_awvalid;
  wire i_axi_awready;
  wire [AW-1:0] i_axi_awaddr;
  wire [3:0] i_axi_awcache;
  wire [2:0] i_axi_awprot;
  wire [1:0] i_axi_awlock;
  wire [1:0] i_axi_awburst;
  wire [3:0] i_axi_awlen;
  wire [2:0] i_axi_awsize;

  wire i_axi_rvalid;
  wire i_axi_rready;
  wire [DW-1:0] i_axi_rdata;
  wire [1:0] i_axi_rresp;
  wire i_axi_rlast;

  wire i_axi_wvalid;
  wire i_axi_wready;
  wire [DW-1:0] i_axi_wdata;
  wire [(DW/8)-1:0] i_axi_wstrb;
  wire i_axi_wlast;

  wire i_axi_bvalid;
  wire i_axi_bready;
  wire [1:0] i_axi_bresp;


  //////////////////////////////////////////////////////////////////
  //////////////////////////////////////////////////////////////////
  // Convert the ICB to AXI Read/Write address and Wdata channel
  //
  //   Generate the AXI address channel valid which is direct got 
  //     from ICB command channel
  assign i_axi_arvalid = i_icb_cmd_valid & i_icb_cmd_read;
  
  // If it is the read transaction, need to pass to AR channel only
  // If it is the write transaction, need to pass to AW and W channel both
      // But in all case, need to check FIFO is not ful
  wire rw_fifo_full;
  assign i_icb_cmd_ready = (~rw_fifo_full) & 
             (i_icb_cmd_read ? i_axi_arready : (i_axi_awready & i_axi_wready));
  assign i_axi_awvalid = i_icb_cmd_valid & (~i_icb_cmd_read) & i_axi_wready  & (~rw_fifo_full);
  assign i_axi_wvalid  = i_icb_cmd_valid & (~i_icb_cmd_read) & i_axi_awready & (~rw_fifo_full); 
  //
  
  //   Generate the AXI address channel address which is direct got 
  //     from ICB command channel
  assign i_axi_araddr = i_icb_cmd_addr;
  assign i_axi_awaddr = i_icb_cmd_addr;
  
  //
  // For these attribute signals we just make it tied to zero
  assign i_axi_arcache = 4'b0;
  assign i_axi_awcache = 4'b0;
  assign i_axi_arprot =  3'b0;
  assign i_axi_awprot =  3'b0;
  assign i_axi_arlock = 2'b0;
  assign i_axi_awlock = 2'b0;
  //
  // The ICB does not support burst now, so just make it fixed
  assign i_axi_arburst = 2'b0;
  assign i_axi_awburst = 2'b0;
  assign i_axi_arlen = 4'b0;
  assign i_axi_awlen = 4'b0;
  
  generate 
    if(DW==32) begin:dw_32
      assign i_axi_arsize = 3'b10;
      assign i_axi_awsize = 3'b10;
    end
    if(DW==64) begin:dw_64
      assign i_axi_arsize = 3'b11;
      assign i_axi_awsize = 3'b11;
    end
  endgenerate
  
  // Generate the Write data channel
  assign i_axi_wdata = i_icb_cmd_wdata;
  assign i_axi_wstrb = i_icb_cmd_wmask;
  assign i_axi_wlast = 1'b1;

  wire rw_fifo_wen = i_icb_cmd_valid & i_icb_cmd_ready;
  wire rw_fifo_ren = i_icb_rsp_valid & i_icb_rsp_ready;

  wire rw_fifo_i_ready;
  wire rw_fifo_i_valid = rw_fifo_wen;
  wire rw_fifo_o_valid ;
  wire rw_fifo_o_ready = rw_fifo_ren;

  assign rw_fifo_full    = (~rw_fifo_i_ready);
  wire rw_fifo_empty   = (~rw_fifo_o_valid);

  wire i_icb_rsp_read;

  sirv_gnrl_fifo # (
    .CUT_READY (FIFO_CUT_READY),
    .MSKO      (1),
    .DP  (FIFO_OUTS_NUM),
    .DW  (1)
  ) u_sirv_gnrl_rw_fifo (
    .i_vld(rw_fifo_i_valid),
    .i_rdy(rw_fifo_i_ready),
    .i_dat(i_icb_cmd_read ),
    .o_vld(rw_fifo_o_valid),
    .o_rdy(rw_fifo_o_ready),  
    .o_dat(i_icb_rsp_read ),  
  
    .clk  (clk),
    .rst_n(rst_n)
  );


//////////////////////////////////////////////////////////////////
//////////////////////////////////////////////////////////////////
// Generate the response channel
  assign i_icb_rsp_valid = i_icb_rsp_read ? i_axi_rvalid : i_axi_bvalid;
  assign i_axi_rready = i_icb_rsp_read & i_icb_rsp_ready;
  assign i_axi_bready = (~i_icb_rsp_read) & i_icb_rsp_ready;

  assign i_icb_rsp_err = i_icb_rsp_read ? i_axi_rresp[1] //SLVERR or DECERR 
                                        : i_axi_bresp[1];
  assign i_icb_rsp_rdata = i_icb_rsp_read ? i_axi_rdata : {DW{1'b0}}; 
  

  sirv_gnrl_axi_buffer #(
     .CHNL_FIFO_DP         (AXI_FIFO_DP       ), 
     .CHNL_FIFO_CUT_READY  (AXI_FIFO_CUT_READY),
     .AW                   (AW),
     .DW                   (DW) 
    ) u_sirv_gnrl_axi_buffer (
    .i_axi_arvalid   (i_axi_arvalid),
    .i_axi_arready   (i_axi_arready),
    .i_axi_araddr    (i_axi_araddr ),
    .i_axi_arcache   (i_axi_arcache),
    .i_axi_arprot    (i_axi_arprot ),
    .i_axi_arlock    (i_axi_arlock ),
    .i_axi_arburst   (i_axi_arburst),
    .i_axi_arlen     (i_axi_arlen  ),
    .i_axi_arsize    (i_axi_arsize ),
                                   
    .i_axi_awvalid   (i_axi_awvalid),
    .i_axi_awready   (i_axi_awready),
    .i_axi_awaddr    (i_axi_awaddr ),
    .i_axi_awcache   (i_axi_awcache),
    .i_axi_awprot    (i_axi_awprot ),
    .i_axi_awlock    (i_axi_awlock ),
    .i_axi_awburst   (i_axi_awburst),
    .i_axi_awlen     (i_axi_awlen  ),
    .i_axi_awsize    (i_axi_awsize ),
                                   
    .i_axi_rvalid    (i_axi_rvalid ),
    .i_axi_rready    (i_axi_rready ),
    .i_axi_rdata     (i_axi_rdata  ),
    .i_axi_rresp     (i_axi_rresp  ),
    .i_axi_rlast     (i_axi_rlast  ),
                                   
    .i_axi_wvalid    (i_axi_wvalid ),
    .i_axi_wready    (i_axi_wready ),
    .i_axi_wdata     (i_axi_wdata  ),
    .i_axi_wstrb     (i_axi_wstrb  ),
    .i_axi_wlast     (i_axi_wlast  ),
                                   
    .i_axi_bvalid    (i_axi_bvalid ),
    .i_axi_bready    (i_axi_bready ),
    .i_axi_bresp     (i_axi_bresp  ),
                                   
    .o_axi_arvalid   (o_axi_arvalid),
    .o_axi_arready   (o_axi_arready),
    .o_axi_araddr    (o_axi_araddr ),
    .o_axi_arcache   (o_axi_arcache),
    .o_axi_arprot    (o_axi_arprot ),
    .o_axi_arlock    (o_axi_arlock ),
    .o_axi_arburst   (o_axi_arburst),
    .o_axi_arlen     (o_axi_arlen  ),
    .o_axi_arsize    (o_axi_arsize ),
                      
    .o_axi_awvalid   (o_axi_awvalid),
    .o_axi_awready   (o_axi_awready),
    .o_axi_awaddr    (o_axi_awaddr ),
    .o_axi_awcache   (o_axi_awcache),
    .o_axi_awprot    (o_axi_awprot ),
    .o_axi_awlock    (o_axi_awlock ),
    .o_axi_awburst   (o_axi_awburst),
    .o_axi_awlen     (o_axi_awlen  ),
    .o_axi_awsize    (o_axi_awsize ),
                     
    .o_axi_rvalid    (o_axi_rvalid ),
    .o_axi_rready    (o_axi_rready ),
    .o_axi_rdata     (o_axi_rdata  ),
    .o_axi_rresp     (o_axi_rresp  ),
    .o_axi_rlast     (o_axi_rlast  ),
                    
    .o_axi_wvalid    (o_axi_wvalid ),
    .o_axi_wready    (o_axi_wready ),
    .o_axi_wdata     (o_axi_wdata  ),
    .o_axi_wstrb     (o_axi_wstrb  ),
    .o_axi_wlast     (o_axi_wlast  ),
                   
    .o_axi_bvalid    (o_axi_bvalid ),
    .o_axi_bready    (o_axi_bready ),
    .o_axi_bresp     (o_axi_bresp  ),
       
    .clk  (clk),
    .rst_n(rst_n)
  );


endmodule


// ===========================================================================
//
// Description:
//  The module to handle the simple-ICB bus to Wishbone bus conversion 
//  Note: in order to support the open source I2C IP, which is 8 bits
//       wide bus and byte-addresable, so here this module is just ICB to 
//       wishbone 8-bits bus conversion
//
// ===========================================================================

module sirv_gnrl_icb32towishb8 # (
  parameter AW = 32 
) (
  input              i_icb_cmd_valid, 
  output             i_icb_cmd_ready, 
  input  [1-1:0]     i_icb_cmd_read, 
  input  [AW-1:0]    i_icb_cmd_addr, 
  input  [32-1:0]    i_icb_cmd_wdata, 
  input  [32/8-1:0]  i_icb_cmd_wmask,
  input  [1:0]       i_icb_cmd_size,

  output             i_icb_rsp_valid, 
  input              i_icb_rsp_ready, 
  output             i_icb_rsp_err,
  output [32-1:0]    i_icb_rsp_rdata, 
  
  // The 8bits wishbone slave (e.g., I2C) must be accessed by load/store byte instructions
  output  [AW-1:0] wb_adr,     // lower address bits
  output  [8-1:0]  wb_dat_w,   // databus input
  input   [8-1:0]  wb_dat_r,   // databus output
  output           wb_we,      // write enable input
  output           wb_stb,     // stobe/core select signal
  output           wb_cyc,     // valid bus cycle input
  input            wb_ack,     // bus cycle acknowledge output

  input  clk,  
  input  rst_n
  );

  assign wb_adr   = i_icb_cmd_addr;
  assign wb_we    = ~i_icb_cmd_read;

  // The 32bits bus to 8bits bus remapping
  assign wb_dat_w = 
             i_icb_cmd_wmask[3] ? i_icb_cmd_wdata[31:24] :
             i_icb_cmd_wmask[2] ? i_icb_cmd_wdata[23:16] :
             i_icb_cmd_wmask[1] ? i_icb_cmd_wdata[15:8] :
             i_icb_cmd_wmask[0] ? i_icb_cmd_wdata[7:0] :
                                  8'b0;
             
             
  wire  [32-1:0]  wb_dat_r_remap = 
                 {24'b0,wb_dat_r} << {i_icb_cmd_addr[1:0],3'b0};
             
  // Since the Wishbone reponse channel does not have handhake scheme, but the
  //   ICB have, so the response may not be accepted by the upstream master
  //   So in order to make sure the functionality is correct, we must put
  //   a reponse bypass-buffer here, to always be able to accept response from wishbone
  //
  sirv_gnrl_fifo # (
   .CUT_READY (1),
   .MSKO      (0),
   .DP(1),
   .DW(32)
  ) u_rsp_fifo(
    .i_vld(wb_ack), 
    .i_rdy(), 
    .i_dat(wb_dat_r_remap),
    .o_vld(i_icb_rsp_valid), 
    .o_rdy(i_icb_rsp_ready), 
    .o_dat(i_icb_rsp_rdata),
  
    .clk  (clk  ),
    .rst_n(rst_n)  
   );

  // We only initiate the reqeust when the response buffer is empty, to make
  //   sure when the response back from wishbone we can alway be able to 
  //   accept it
  assign wb_stb          = (~i_icb_rsp_valid) & i_icb_cmd_valid;
  assign wb_cyc          = (~i_icb_rsp_valid) & i_icb_cmd_valid;
  assign i_icb_cmd_ready = (~i_icb_rsp_valid) & wb_ack;


  assign i_icb_rsp_err = 1'b0;// Wishbone have no error response

endmodule

// ===========================================================================
//
// Description:
//  The module to handle the simple-ICB bus to APB bus conversion 
//
// ===========================================================================

module sirv_gnrl_icb2apb # (
  parameter AW = 32,
  parameter FIFO_OUTS_NUM = 8,
  parameter FIFO_CUT_READY = 0,
  parameter DW = 64 // 64 or 32 bits
) (
  input              i_icb_cmd_valid, 
  output             i_icb_cmd_ready, 
  input  [1-1:0]     i_icb_cmd_read, 
  input  [AW-1:0]    i_icb_cmd_addr, 
  input  [DW-1:0]    i_icb_cmd_wdata, 
  input  [DW/8-1:0]  i_icb_cmd_wmask,
  input  [1:0]       i_icb_cmd_size,

  output             i_icb_rsp_valid, 
  input              i_icb_rsp_ready, 
  output             i_icb_rsp_err,
  output [DW-1:0]    i_icb_rsp_rdata, 
  
  output [AW-1:0] apb_paddr,
  output          apb_pwrite,
  output          apb_pselx,
  output          apb_penable,
  output [DW-1:0] apb_pwdata,
  input  [DW-1:0] apb_prdata,

  input  clk,  
  input  rst_n
  );

  // Since the APB reponse channel does not have handhake scheme, but the
  //   ICB have, so the response may not be accepted by the upstream master
  //   So in order to make sure the functionality is correct, we must put
  //   a reponse bypass-buffer here, to always be able to accept response from apb
  //
  wire apb_enable_r;

  sirv_gnrl_fifo # (
   .CUT_READY (1),
   .MSKO      (0),
   .DP(1),
   .DW(DW)
  ) u_rsp_fifo(
    .i_vld(apb_enable_r), 
    .i_rdy(), 
    .i_dat(apb_prdata),
    .o_vld(i_icb_rsp_valid), 
    .o_rdy(i_icb_rsp_ready), 
    .o_dat(i_icb_rsp_rdata),
  
    .clk  (clk  ),
    .rst_n(rst_n)  
   );

  assign i_icb_rsp_err = 1'b0;// Wishbone have no error response

    // apb enable will be set if it is now not set and the new icb valid is coming
          // And we only initiate the reqeust when the response buffer is empty, to make
          //   sure when the response back from APB we can alway be able to 
  wire apb_enable_set = (~apb_enable_r) & i_icb_cmd_valid & (~i_icb_rsp_valid);
    // apb enable will be clear if it is now already set
  wire apb_enable_clr = apb_enable_r;
  wire apb_enable_ena = apb_enable_set | apb_enable_clr;
  wire apb_enable_nxt = apb_enable_set & (~apb_enable_clr);
  sirv_gnrl_dfflr #(1) apb_enable_dfflr (apb_enable_ena, apb_enable_nxt, apb_enable_r, clk, rst_n);

  assign i_icb_cmd_ready = apb_enable_r & (~i_icb_rsp_valid);

  assign apb_paddr  = i_icb_cmd_addr;
  assign apb_pwrite = (~i_icb_cmd_read);
  assign apb_pselx  = i_icb_cmd_valid;
  assign apb_penable= apb_enable_r;
  assign apb_pwdata = i_icb_cmd_wdata;

endmodule


// ===========================================================================
//
// Description:
//  The module to handle the simple-ICB bus to AHB-lite bus conversion 
//
// ===========================================================================
module sirv_gnrl_icb2ahbl #(
    parameter AW = 32,
    parameter DW = 32 
) (

  input              icb_cmd_valid,
  output             icb_cmd_ready,
  input              icb_cmd_read,
  input  [AW-1:0]    icb_cmd_addr,
  input  [DW-1:0]    icb_cmd_wdata,
  input  [DW/8-1:0]  icb_cmd_wmask,
  input  [1:0]       icb_cmd_size,
  input              icb_cmd_lock,
  input              icb_cmd_excl,
  input  [1:0]       icb_cmd_burst, 
  input  [1:0]       icb_cmd_beat, 

  output             icb_rsp_valid, 
  input              icb_rsp_ready, 
  output             icb_rsp_err,
  output             icb_rsp_excl_ok,
  output [DW-1:0]    icb_rsp_rdata, 

  output [1:0]       ahbl_htrans,   
  output             ahbl_hwrite,   
  output [AW-1:0]    ahbl_haddr,    
  output [2:0]       ahbl_hsize,    
  output             ahbl_hlock,   
  output             ahbl_hexcl,   
  output [2:0]       ahbl_hburst,   
  output [DW-1:0]    ahbl_hwdata,   
  output [3:0]       ahbl_hprot, 
  output [1:0]       ahbl_hattri,
  output [1:0]       ahbl_master,
  input  [DW-1:0]    ahbl_hrdata,   
  input  [1:0]       ahbl_hresp,    
  input              ahbl_hresp_exok,    
  input              ahbl_hready,   
       
  input              clk,          
  input              rst_n         
  );

  wire ahbl_eff_trans = ahbl_hready & ahbl_htrans[1];

  assign icb_cmd_ready  = ahbl_hready;
  assign ahbl_htrans[1] = icb_cmd_valid;
  assign ahbl_htrans[0] = 1'b0;

  /////////////////////////////////////////////////////////////
  // FSM to check the AHB state
  localparam FSM_W  = 2;
  localparam STA_AR = 2'b00; 
  localparam STA_WD = 2'b01;
  localparam STA_RD = 2'b10;

  wire[FSM_W-1:0] ahbl_sta_r;
  wire[FSM_W-1:0] ahbl_sta_nxt;

  wire to_wd_sta = ahbl_eff_trans & ahbl_hwrite;
  wire to_rd_sta = ahbl_eff_trans & (~ahbl_hwrite);
  wire to_ar_sta = ahbl_hready    & (~ahbl_htrans[1]);

  wire  ahbl_sta_is_ar = (ahbl_sta_r == STA_AR);

  // FSM Next state comb logics
  assign ahbl_sta_nxt = ahbl_hready ?  (
                               {FSM_W{to_ar_sta}} & (STA_AR) 
                             | {FSM_W{to_wd_sta}} & (STA_WD)
                             | {FSM_W{to_rd_sta}} & (STA_RD)
                         ) : ahbl_sta_r;

  // FSM sequential logics
  sirv_gnrl_dffr #(FSM_W) ahbl_sta_dffr (ahbl_sta_nxt, ahbl_sta_r, clk, rst_n);
  
  wire [DW-1:0]ahbl_hwdata_r;
  wire ahbl_hwdata_ena = to_wd_sta;
  sirv_gnrl_dfflr #(DW) ahbl_hwdata_dfflr (ahbl_hwdata_ena, icb_cmd_wdata, ahbl_hwdata_r, clk, rst_n);

  // AHB control signal generation

  assign ahbl_hwrite = ~icb_cmd_read;    
  assign ahbl_haddr  = icb_cmd_addr;    
  assign ahbl_hsize  = {1'b0,icb_cmd_size};    
  assign ahbl_hexcl  = icb_cmd_excl;    
  assign ahbl_hwdata = ahbl_hwdata_r;

  assign ahbl_hprot  = 4'b0;
  assign ahbl_hattri = 2'b0;
  assign ahbl_hlock  = 1'b0;
  assign ahbl_master = 2'b0;
  assign ahbl_hburst = 3'b0;

  assign icb_rsp_valid     = ahbl_hready & (~ahbl_sta_is_ar);  
  assign icb_rsp_rdata     = ahbl_hrdata;   
  assign icb_rsp_err       = ahbl_hresp[0];
  assign icb_rsp_excl_ok   = ahbl_hresp_exok;


endmodule


// ===========================================================================
//
// Description:
//  Verilog module for the AXI bus pipeline stage
//
// ===========================================================================

module sirv_gnrl_axi_buffer
  #(
    parameter CHNL_FIFO_DP = 2,
    parameter CHNL_FIFO_CUT_READY = 2,
    parameter AW = 32,
    parameter DW = 32 
    )
  (
  input  i_axi_arvalid,
  output i_axi_arready,
  input  [AW-1:0] i_axi_araddr,
  input  [3:0] i_axi_arcache,
  input  [2:0] i_axi_arprot,
  input  [1:0] i_axi_arlock,
  input  [1:0] i_axi_arburst,
  input  [3:0] i_axi_arlen,
  input  [2:0] i_axi_arsize,

  input  i_axi_awvalid,
  output i_axi_awready,
  input  [AW-1:0] i_axi_awaddr,
  input  [3:0] i_axi_awcache,
  input  [2:0] i_axi_awprot,
  input  [1:0] i_axi_awlock,
  input  [1:0] i_axi_awburst,
  input  [3:0] i_axi_awlen,
  input  [2:0] i_axi_awsize,

  output i_axi_rvalid,
  input  i_axi_rready,
  output [DW-1:0] i_axi_rdata,
  output [1:0] i_axi_rresp,
  output i_axi_rlast,

  input  i_axi_wvalid,
  output i_axi_wready,
  input  [DW-1:0] i_axi_wdata,
  input  [(DW/8)-1:0] i_axi_wstrb,
  input  i_axi_wlast,

  output i_axi_bvalid,
  input  i_axi_bready,
  output [1:0] i_axi_bresp,

  output o_axi_arvalid,
  input  o_axi_arready,
  output [AW-1:0] o_axi_araddr,
  output [3:0] o_axi_arcache,
  output [2:0] o_axi_arprot,
  output [1:0] o_axi_arlock,
  output [1:0] o_axi_arburst,
  output [3:0] o_axi_arlen,
  output [2:0] o_axi_arsize,

  output o_axi_awvalid,
  input  o_axi_awready,
  output [AW-1:0] o_axi_awaddr,
  output [3:0] o_axi_awcache,
  output [2:0] o_axi_awprot,
  output [1:0] o_axi_awlock,
  output [1:0] o_axi_awburst,
  output [3:0] o_axi_awlen,
  output [2:0] o_axi_awsize,

  input  o_axi_rvalid,
  output o_axi_rready,
  input  [DW-1:0] o_axi_rdata,
  input  [1:0] o_axi_rresp,
  input  o_axi_rlast,

  output o_axi_wvalid,
  input  o_axi_wready,
  output [DW-1:0] o_axi_wdata,
  output [(DW/8)-1:0] o_axi_wstrb,
  output o_axi_wlast,

  input  o_axi_bvalid,
  output o_axi_bready,
  input  [1:0] o_axi_bresp,
       
  input  clk,  
  input  rst_n 
  );


localparam AR_CHNL_W = 4+3+2+4+3+2+AW;
localparam AW_CHNL_W = AR_CHNL_W;

wire [AR_CHNL_W -1:0] i_axi_ar_chnl = 
    {
    i_axi_araddr,
    i_axi_arcache,
    i_axi_arprot ,
    i_axi_arlock ,
    i_axi_arburst,
    i_axi_arlen  ,
    i_axi_arsize  
    };

wire [AR_CHNL_W -1:0] o_axi_ar_chnl;
assign   {
    o_axi_araddr,
    o_axi_arcache,
    o_axi_arprot ,
    o_axi_arlock ,
    o_axi_arburst,
    o_axi_arlen  ,
    o_axi_arsize   
    } = o_axi_ar_chnl;

sirv_gnrl_fifo #(
    .CUT_READY (CHNL_FIFO_CUT_READY),
    .MSKO      (0),
    .DP  (CHNL_FIFO_DP),
    .DW  (AR_CHNL_W)
) o_axi_ar_fifo (
  .i_rdy    (i_axi_arready),
  .i_vld    (i_axi_arvalid),
  .i_dat    (i_axi_ar_chnl),

  .o_rdy    (o_axi_arready),
  .o_vld    (o_axi_arvalid),
  .o_dat    (o_axi_ar_chnl),

  .clk      (clk  ),
  .rst_n    (rst_n)
  );


wire [AW_CHNL_W-1:0] i_axi_aw_chnl = 
    {
    i_axi_awaddr,
    i_axi_awcache,
    i_axi_awprot ,
    i_axi_awlock ,
    i_axi_awburst,
    i_axi_awlen  ,
    i_axi_awsize  
    };

wire [AW_CHNL_W-1:0] o_axi_aw_chnl;
assign   {
    o_axi_awaddr,
    o_axi_awcache,
    o_axi_awprot ,
    o_axi_awlock ,
    o_axi_awburst,
    o_axi_awlen  ,
    o_axi_awsize  
    } = o_axi_aw_chnl;

sirv_gnrl_fifo #(
    .CUT_READY (CHNL_FIFO_CUT_READY),
    .MSKO      (0),
    .DP  (CHNL_FIFO_DP),
    .DW  (AW_CHNL_W)
) o_axi_aw_fifo (
  .i_rdy    (i_axi_awready),
  .i_vld    (i_axi_awvalid),
  .i_dat    (i_axi_aw_chnl ),

  .o_rdy    (o_axi_awready ),
  .o_vld    (o_axi_awvalid ),
  .o_dat    (o_axi_aw_chnl),

  .clk      (clk  ),
  .rst_n    (rst_n)
  );


localparam W_CHNL_W = DW+(DW/8)+1;
wire [W_CHNL_W-1:0] i_axi_w_chnl = {
                                                i_axi_wdata,
                                                i_axi_wstrb,
                                                i_axi_wlast
                                                 };
wire [W_CHNL_W-1:0] o_axi_w_chnl;
assign { 
         o_axi_wdata,
         o_axi_wstrb,
         o_axi_wlast} = o_axi_w_chnl;

sirv_gnrl_fifo #(
    .CUT_READY (CHNL_FIFO_CUT_READY),
    .MSKO      (0),
    .DP  (CHNL_FIFO_DP),
    .DW  (W_CHNL_W)
) o_axi_wdata_fifo(
  .i_rdy    (i_axi_wready),
  .i_vld    (i_axi_wvalid),
  .i_dat    (i_axi_w_chnl ),

  .o_rdy    (o_axi_wready),
  .o_vld    (o_axi_wvalid),
  .o_dat    (o_axi_w_chnl),

  .clk        (clk  ),
  .rst_n      (rst_n)
);
//


localparam R_CHNL_W = DW+2+1;
wire [R_CHNL_W-1:0] o_axi_r_chnl = {
                                                o_axi_rdata,
                                                o_axi_rresp,
                                                o_axi_rlast 
                                                 };
wire [R_CHNL_W-1:0] i_axi_r_chnl;
assign {
        i_axi_rdata,
        i_axi_rresp,
        i_axi_rlast} = i_axi_r_chnl;

sirv_gnrl_fifo # (
    .CUT_READY (CHNL_FIFO_CUT_READY),
    .MSKO      (0),
    .DP  (CHNL_FIFO_DP),
    .DW  (R_CHNL_W)
) o_axi_rdata_fifo(
  .i_rdy    (o_axi_rready),
  .i_vld    (o_axi_rvalid),
  .i_dat    (o_axi_r_chnl ),


  .o_rdy    (i_axi_rready),
  .o_vld    (i_axi_rvalid),
  .o_dat    (i_axi_r_chnl),
  .clk      (clk  ),
  .rst_n    (rst_n)
);
//


localparam B_CHNL_W = 2;

wire [B_CHNL_W -1:0] o_axi_b_chnl = {
           o_axi_bresp
           };

wire [B_CHNL_W -1:0] i_axi_b_chnl;
assign {
           i_axi_bresp
           } = i_axi_b_chnl;

sirv_gnrl_fifo #(
    .CUT_READY (CHNL_FIFO_CUT_READY),
    .MSKO      (0),
    .DP  (CHNL_FIFO_DP),
    .DW  (B_CHNL_W)
) o_axi_bresp_fifo (
  .i_rdy    (o_axi_bready     ),
  .i_vld    (o_axi_bvalid     ),
  .i_dat    (o_axi_b_chnl),

  .o_rdy    (i_axi_bready),
  .o_vld    (i_axi_bvalid),
  .o_dat    (i_axi_b_chnl),

  .clk       (clk  ),
  .rst_n     (rst_n)
  );



endmodule 
