riscv-mcu/e203_hbirdv2/(commit log)

2020-08-04 rtl: fix a bug in PLIC fpga: regenerate mcs file
    [sirv_plic_man.v]
2020-08-11 rtl: update spi interrupt related logic
2020-08-11 fpga: regenerate mcs file as SPI IP updated
2020-08-13 rtl: add parity sel and update interrupt s&c for UART, del some useless logic in SPI
2020-08-14 fpga: regenerate mcs file as UART IP updated
2020-11-20 rtl: remove unused module and add one more UART
2020-11-20 fpga: add new development board MCU200T support for Hbirdv2 SoC
2020-11-20 doc: update hbirdv2 SoC architecture diagram and add MCU200T board pic
2021-05-10 rtl: fix a bug about interrupt generation in UART
    [uart_interrupt.v]
2023-03-10 add FuseSoC core files for E203 Core / Hummingbird v2 SoC
2024-09-05 Fix typo in e203_exu_decode.v
    [e203_exu_decode.v]
