riscv-mcu/e203_hbirdv2/(notices)

Notices in the files:
rtl/e203/perips/apb_i2c/i2c_master_bit_ctrl.v:
Copyright (C) 2001 Richard Herveille
